CValadez94/F20_Schematics/PDM_Layout.pdf

Specs

Page 1

R1 | R4 | F2 ECU BAT 10A | F8 FPUMP RLY 20A | F14 SHIFTERS 5A
MAIN | INJ | F3 ECU IGN 3A | F9 INJ RLY 30A | F15 ECU +5V_1 3A
R2 | R5 | F4 MAIN RLY 30A | F10 COILS RLY 30A | F16 ECU +5V_2 3A
FAN | COILS | F5 ECU 12V RLY 20A | F11 AUX RLY 10A
R3 FUEL | R6 | F6 O2 SENSOR 5A | F12 RIM 2A
| AUX | F7 FAN RLY 30A | F13 TRANSP 1A
