CValadez94/F20_Schematics/ConnPinout.xlsx

Sheet: Connectors
IC = inter connect
CC = component connector
PT = pigtail
RT = ring terminal
R = receptacle
P = plug
SH = shield
Ref | Start | End | Ckt ID | Color | AWG
ICP1 | 1 | S1:1 | 1BP | RED
 | 2 | CCP1:2 | 1CT1
 | 3 | CCP2:2 | 1CT2
 | 4 | CCP3:2 | 1CT3
 | 5 | CCP4:2 | 1CT4
 | 6 | S2:1 | 2BP | RED
 | 7 | CCR1:1 | 3CT1
 | 8 | CCR1:2 | 3CT2
 | 9 | CCR1:3 | 3CT3
 | 10 | CCR1:4 | 3CT4
 | 11 | CCR2:3 | 3BG | BLACK
 | 12 | RT1 | 4BP | RED
 | 13 | ICR7:1 | 5BP | RED
 | 14 | S3:1 | 6AP2 | RED
 | 15 | S4:1 | 7AG1 | GRAY
 | 16 | ICR5:1 | 8SI
 | 17 | ICR6:1 | 9SI
 | 18 | ICR2:1 | 10SI
 | 19 | ICR3:1 | 11SI
 | 20 | ICR4:1 | 12SI
 | 21 | ICP6:1 | 22SI
ICR1 | 1 |  | 13SI
 | 2 |  | 14SI
 | SH |  | 13SH
ICP2 | 1 |  | 15SI
 | 2 |  | 16SI
 | SH |  | 15SH
ICR8 | 1 | S5 | 21BP
 | 2 |  | 18CT
 | 3 |  | 19CT
ICR9 | 1 | S5 | 21BP
 | 2 |  | 20CT
CCR2 | 1 | CCP5:2 | 2CT1
 | 2 | CCP6:2 | 2CT2
 | 3 | ICP1:11 | 3BG | BLACK
 | 4 | CCP7:2 | 2CT3
 | 5 | CCP8:2 | 2CT4
S1 | 1 | ICP1:1 | 1BP | RED
 | 2 | CCP1:1 | 1BP
 | 3 | CCP2:1 | 1BP
 | 4 | CCP3:1 | 1BP
 | 5 | CCP4:1 | 1BP
S2 | 1 | ICP1:6 | 2BP
 | 2 | CCP5:1 | 2BP
 | 3 | CCP6:1 | 2BP
 | 4 | CCP7:1 | 2BP
 | 5 | CCP8:1 | 2BP
S3 | 1 | ICP1:14 | 6AP2 | RED
 | 2 | ICR2:2 | 6AP2
 | 3 | ICR3:3 | 6AP2
 | 4 | ICR4:2 | 6AP2
 | 5 | ICR5:3 | 6AP2
 | 6 | ICR6:3 | 6AP2
S4 | 1 | ICP1:15 | 7AG1 | GRAY
 | 2 | ICR3:2 | 7AG1
 | 3 | ICR5:2 | 7AG1
 | 4 | ICR6:2 | 7AG1
S5 | 1 |  | 21BP
 | 2 | ICR9:1 | 21BP
 | 3 | ICR8:1 | 21BP

Sheet: Circut ID Naming
Ex | 1BP = Injectors Battery Power (12V)
Ckt Number |  | Type |  | Misc Flag (Optional)
1 | Injectors | BP | Battery Power (12V) | Chronological numbering scheme to differentiate multiples. For example, (1CT1, 1CT2, 1CT3, 1CT4) refers to control wires of injectors 1, 2, 3 and 4 respectively.
2 | Coils | AP | Aux Power (5V)
3 | Coil Driver | BG | Battery Ground
4 | Fuel Pump | CG | Chassis Ground
5 | Fan | AG | Analog Ground
6 | ECU_+5V | CT | Control
7 | ECU_AGND | DD | Digital Data
8 | TPS | SI | Signal
9 | MAP | SH | Wire shielding
10 | ECT
11 | EOP
12 | IAT
13 | Crank_VR+
14 | Crank_VR-
15 | Cam_VR+
16 | Cam_VR-
17 | O2 Sensor
18 | Up Shift
19 | Down Shift
20 | Clutch
21 | Shift Solenoids
22 | Brake Light
23
24
25
26
27
28
29
30
