CValadez94/F20_Schematics/PDM_Layout.xlsx

Sheet: Specs
R1 MAIN | R4 INJ | F2 ECU BAT 10A | F2 ECU BAT 10A | F8 FPUMP RLY 20A | F14 SHIFTERS 5A
 |  | F3 ECU IGN 3A |  | F9 INJ RLY 30A | F15 ECU +5V_1 3A
R2 FAN | R5 COILS | F4 MAIN RLY 30A | F4 MAIN RLY 30A | F10 COILS RLY 30A | F16 ECU +5V_2 3A
 |  | F5 ECU 12V RLY 20A |  | F11 AUX RLY 10A
R3 FUEL | R6 AUX | F6 O2 SENSOR 5A |  | F12 RIM 2A
 |  | F7 FAN RLY 30A |  | F13 TRANSP 1A

Sheet: Sheet1
6 ultra micro relays (4pin – 20A) 24 fuses
6 micro relays (4/5 pin – 35A) 18 fuses
5 micro relays (4/5 pin – 35A) 20 fuses
