CValadez94/F20_Schematics/WiringDiagrams.pdf

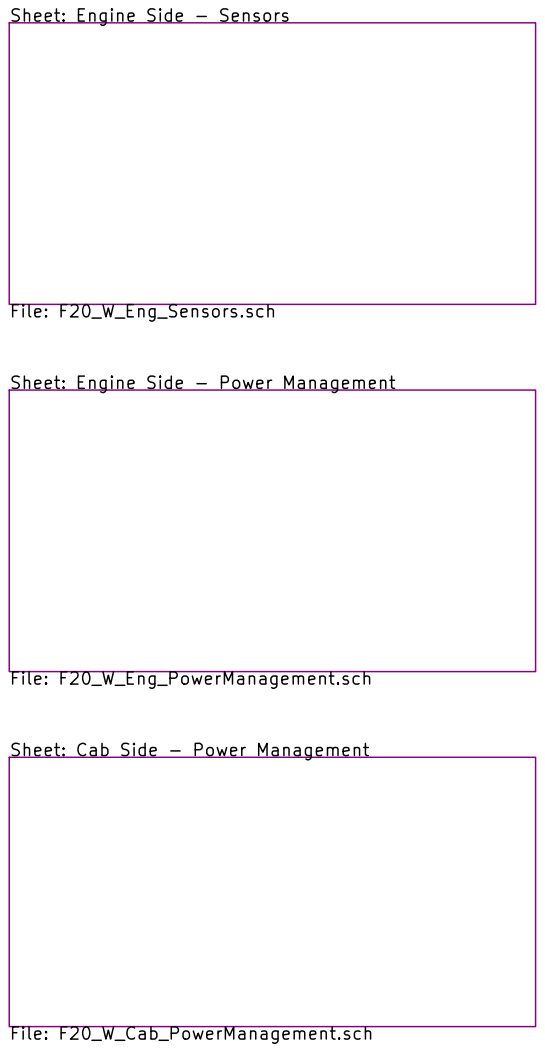
[picture p1: page 1]

Sheet: Engine Side - Sensors

Sheet: Engine Side - Power Management

Sheet: Cab Side - Power Management

Id: 1/4 Title: Root - Wiring

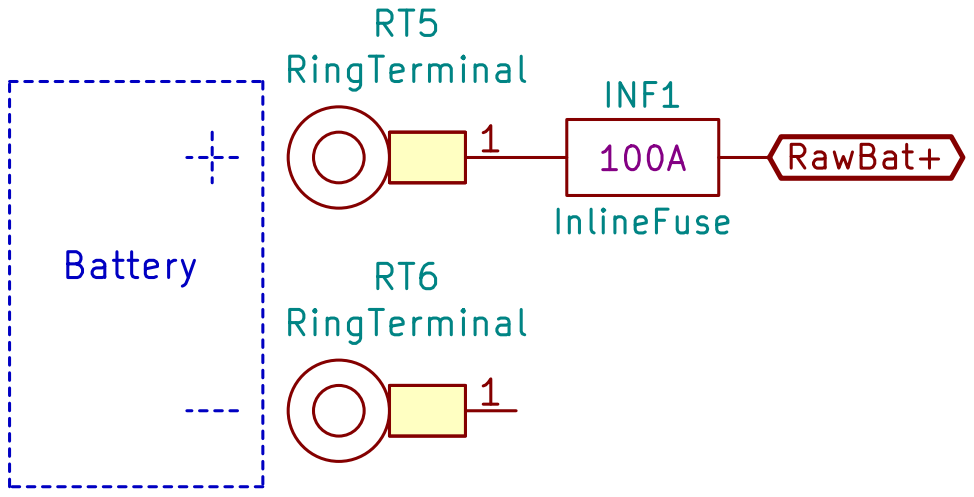
[picture p2: page 2]

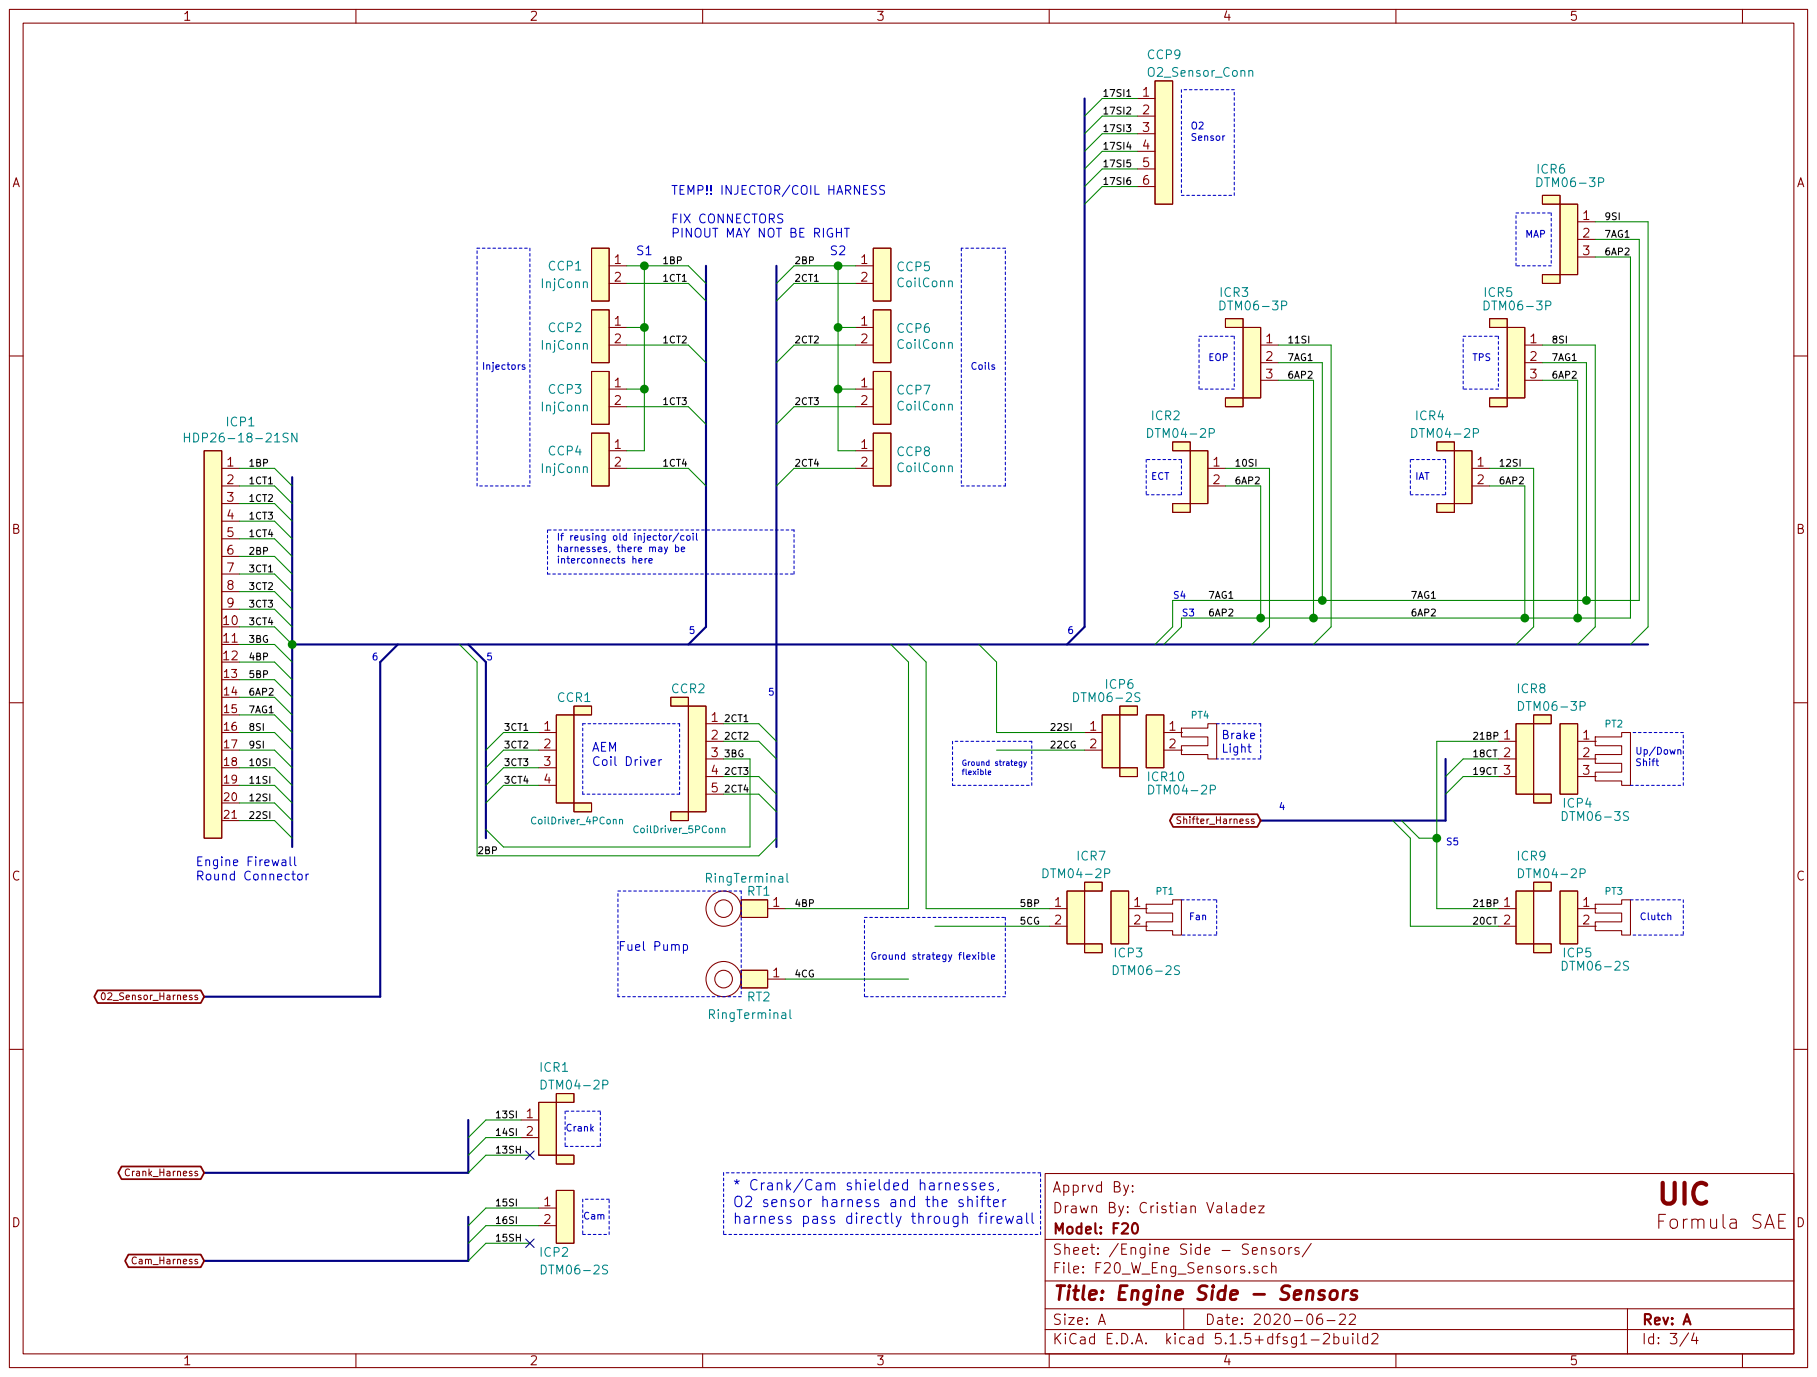
[picture p3: page 3]

1CT1 TEMP!! INJECTOR/COIL HARNESS

FIX CONNECTORS
PINOUT MAY NOT BE RIGHT

If reusing old injector/coil harnesses, there may be

Fan Crank Engine Firewall Round Connector

* Crank/Cam shielded harnesses, O2 sensor harness and the shifter harness pass directly through firewall

File: F20_W_Eng_Sensors.sch
Id: 3/4 Title: Engine Side - Sensors

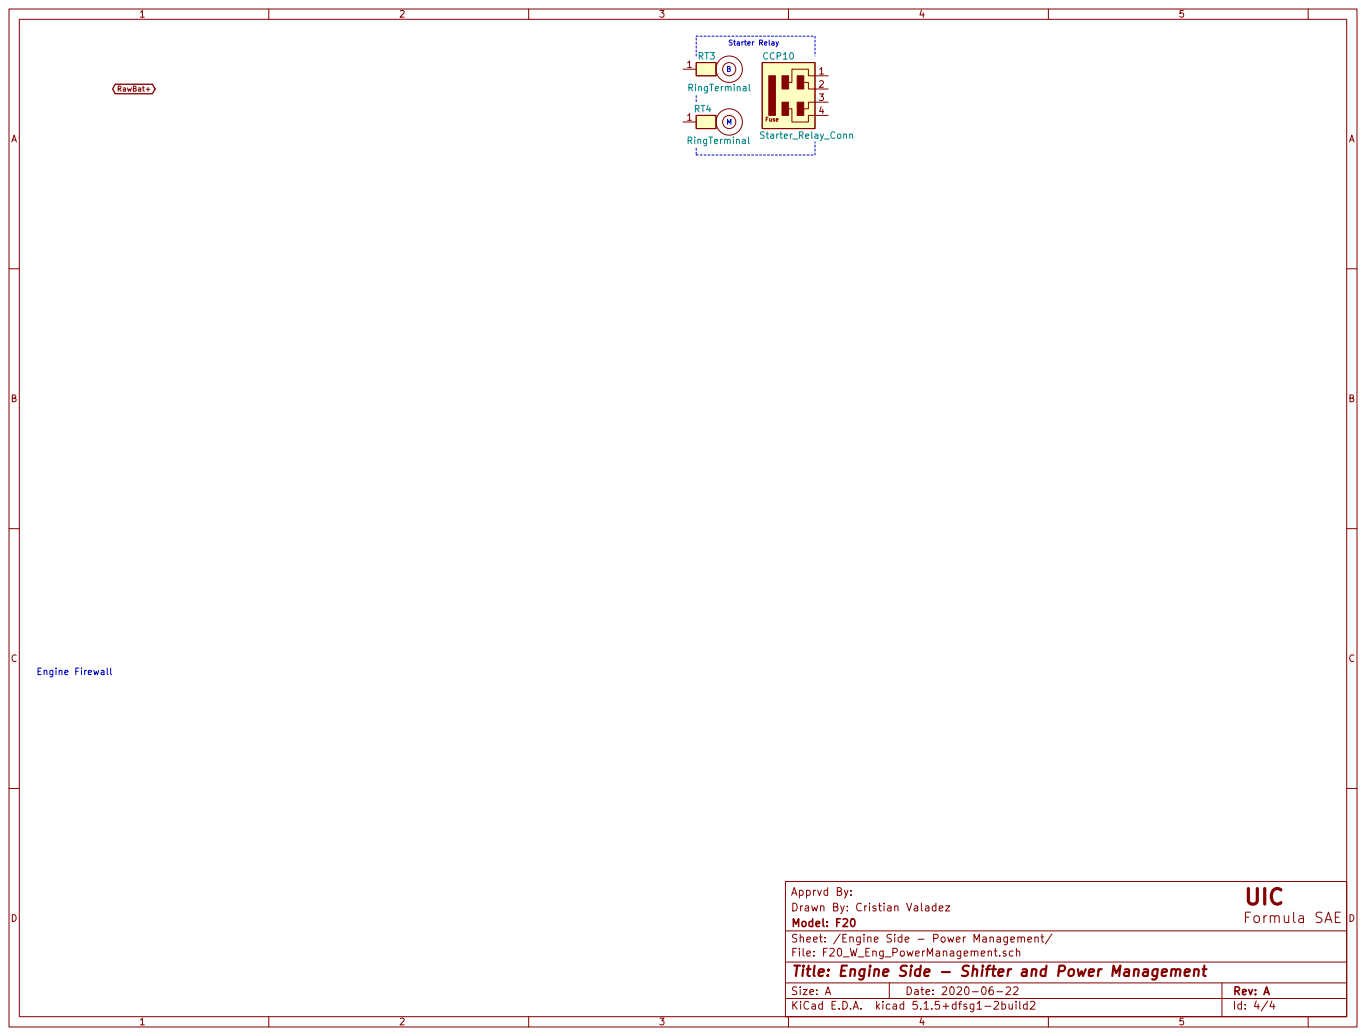
[picture p4: page 4]

File: F20_W_Eng_PowerManagement.sch
Id: 4/4 Title: Engine Side - Shifter and Power Management
