CValadez94/F20_Schematics/LogicDiagrams.pdf

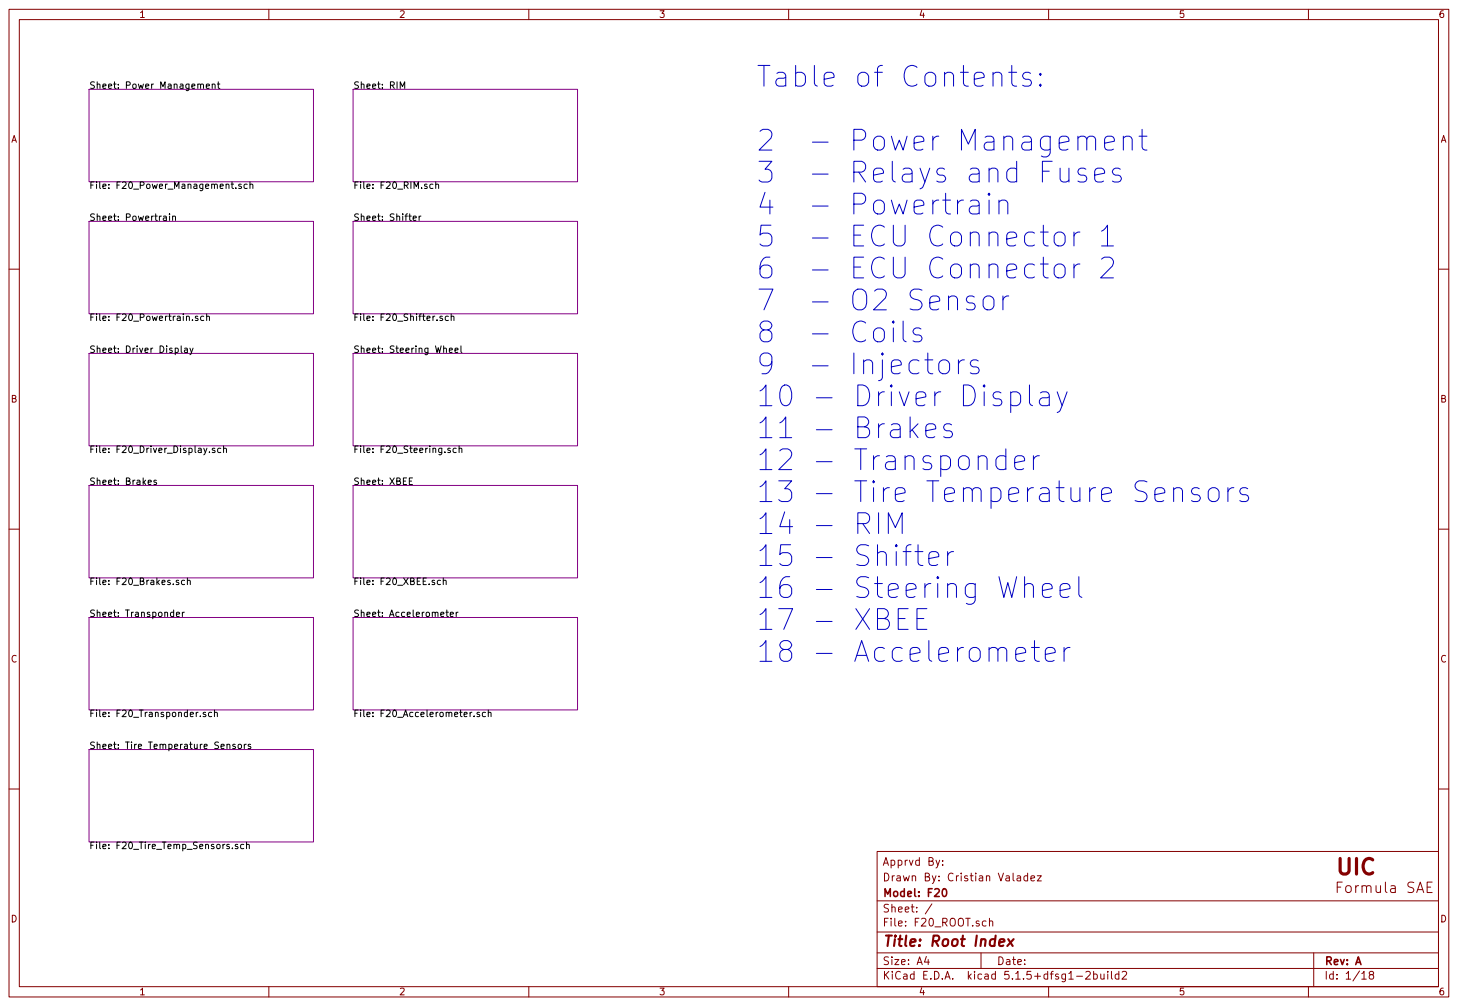
[picture p5: page 1]

File: F20_Power_Management.sch Sheet: Powertrain File: F20_Powertrain.sch Sheet: Driver Display

File: F20_RIM.sch Sheet: Shifter File: F20_Shifter.sch Sheet: Steering Wheel

File: F20_Driver_Display.sch Sheet: Brakes File: F20_Brakes.sch Sheet: Transponder

File: F20_Steering.sch Sheet: XBEE

Sheet: Tire Temperature Sensors

Id: 1/18 Title: Root Index

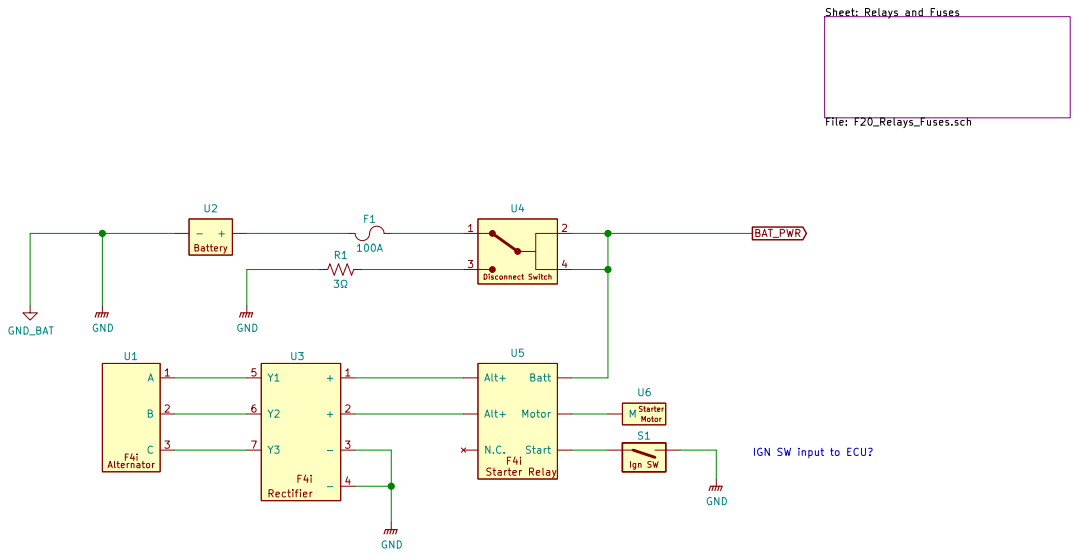
[picture p6: page 2]

Sheet: Relays and Fuses

IGN SW input to ECU?

File: F20_Power_Management.sch
Id: 2/18 Title: Fuses and Relays

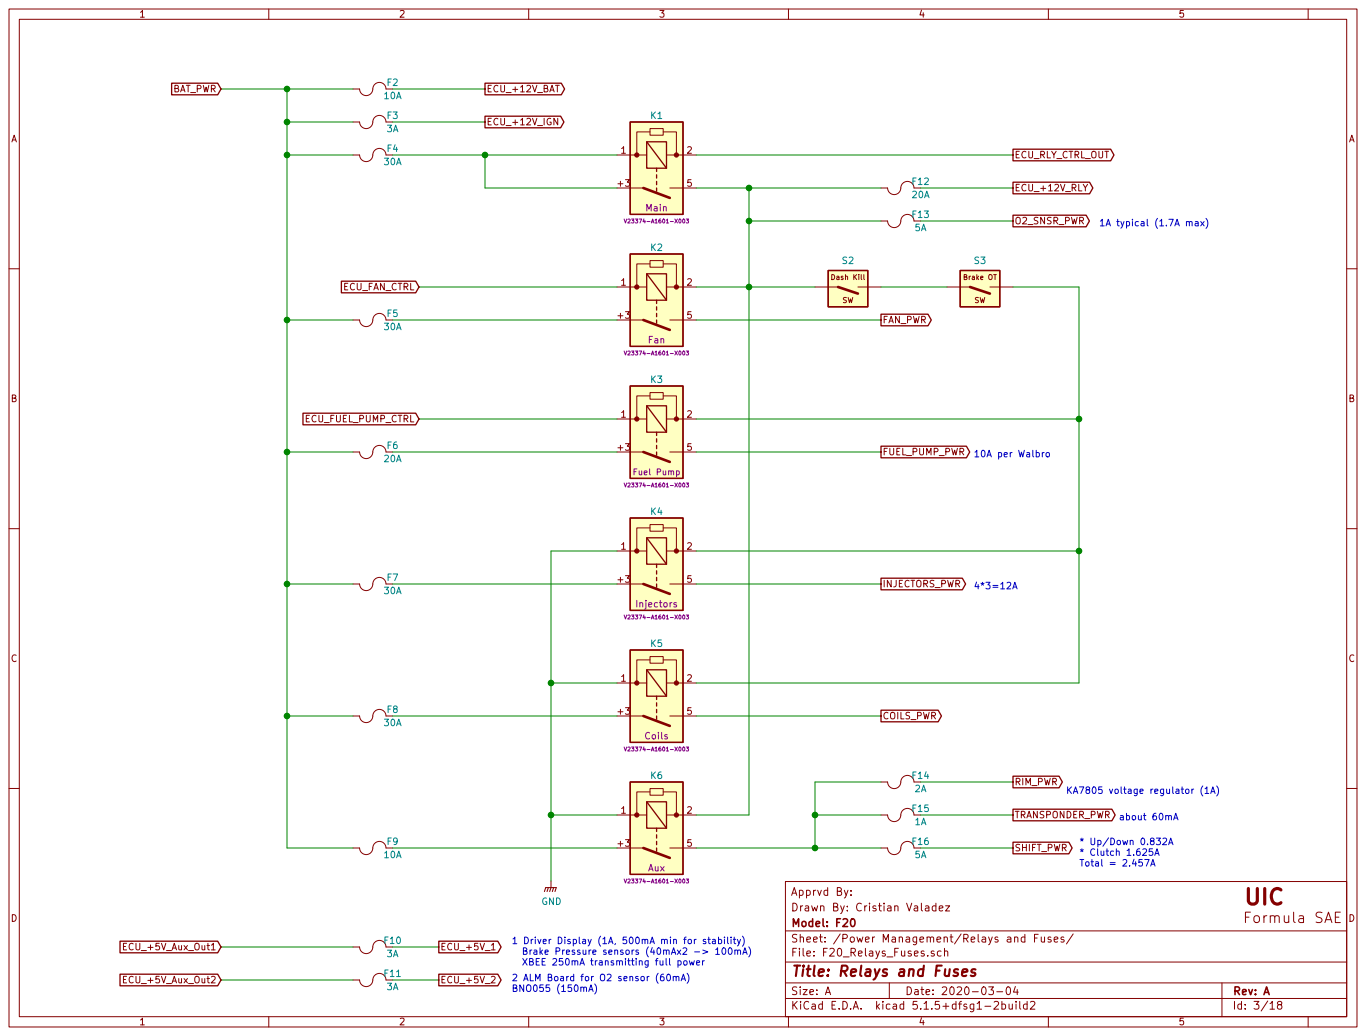
[picture p7: page 3]

1 Driver Display (1A, 500mA min for stability)
Brake Pressure sensors (40mAx2 -> 100mA)
XBEE 250mA transmitting full power
2 ALM Board for O2 sensor (60mA)

File: F20_Relays_Fuses.sch
Id: 3/18 Title: Relays and Fuses

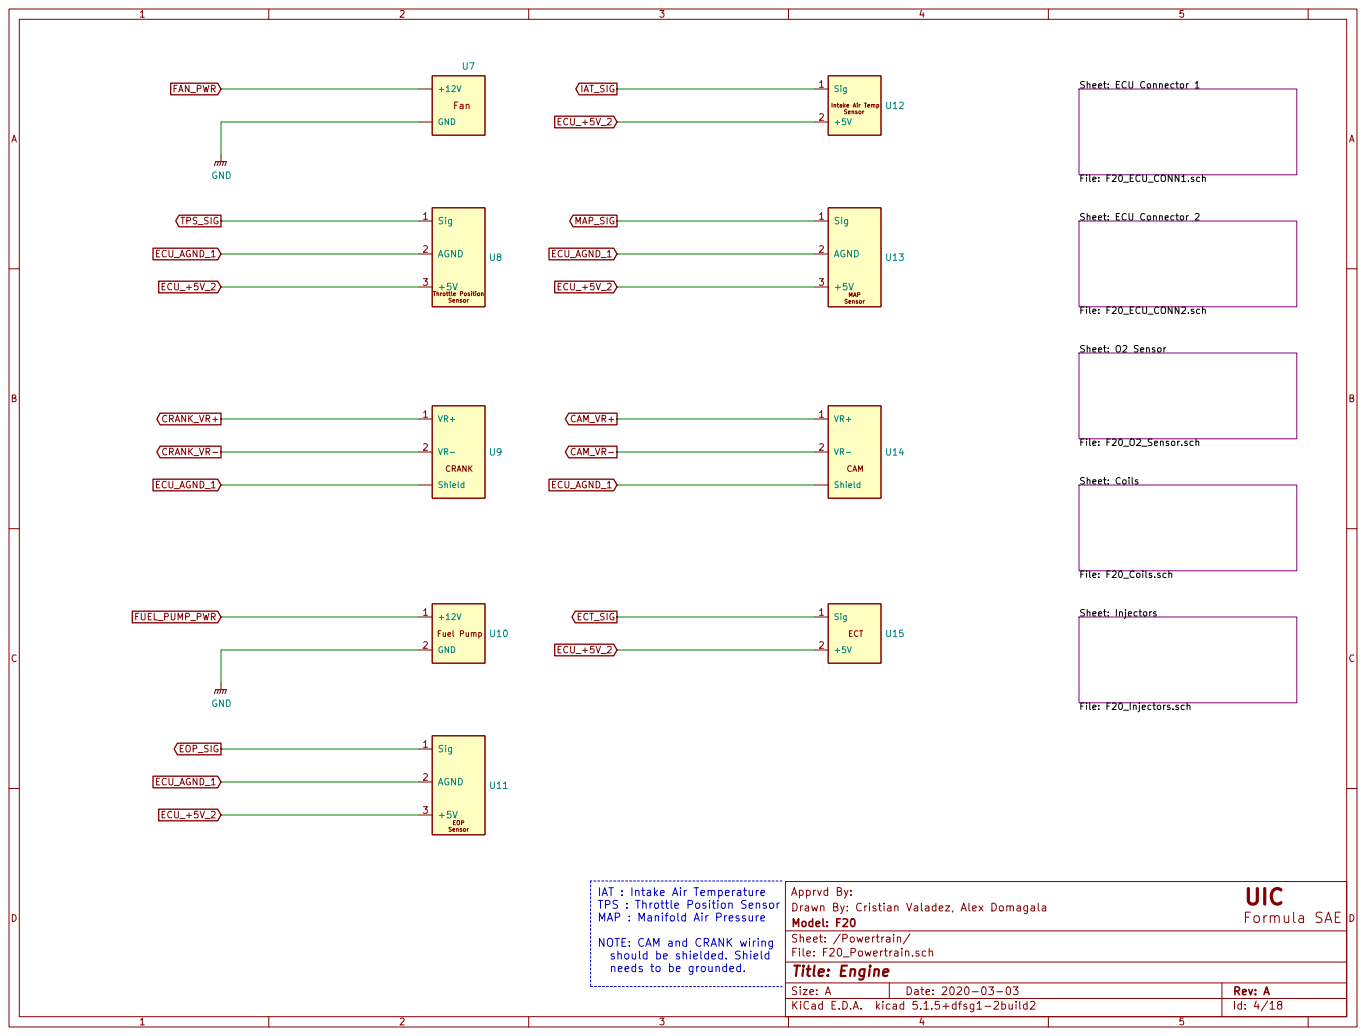
[picture p8: page 4]

Sheet: ECU Connector 1 File: F20_ECU_CONN1.sch GND

Intake Air Temp Sensor Sig 1
Sheet: ECU Connector 2 File: F20_ECU_CONN2.sch Sheet: O2 Sensor File: F20_O2_Sensor.sch Sheet: Coils File: F20_Coils.sch Sheet: Injectors

IAT : Intake Air Temperature
TPS : Throttle Position Sensor MAP : Manifold Air Pressure NOTE: CAM and CRANK wiring

should be shielded. Shield
needs to be grounded.

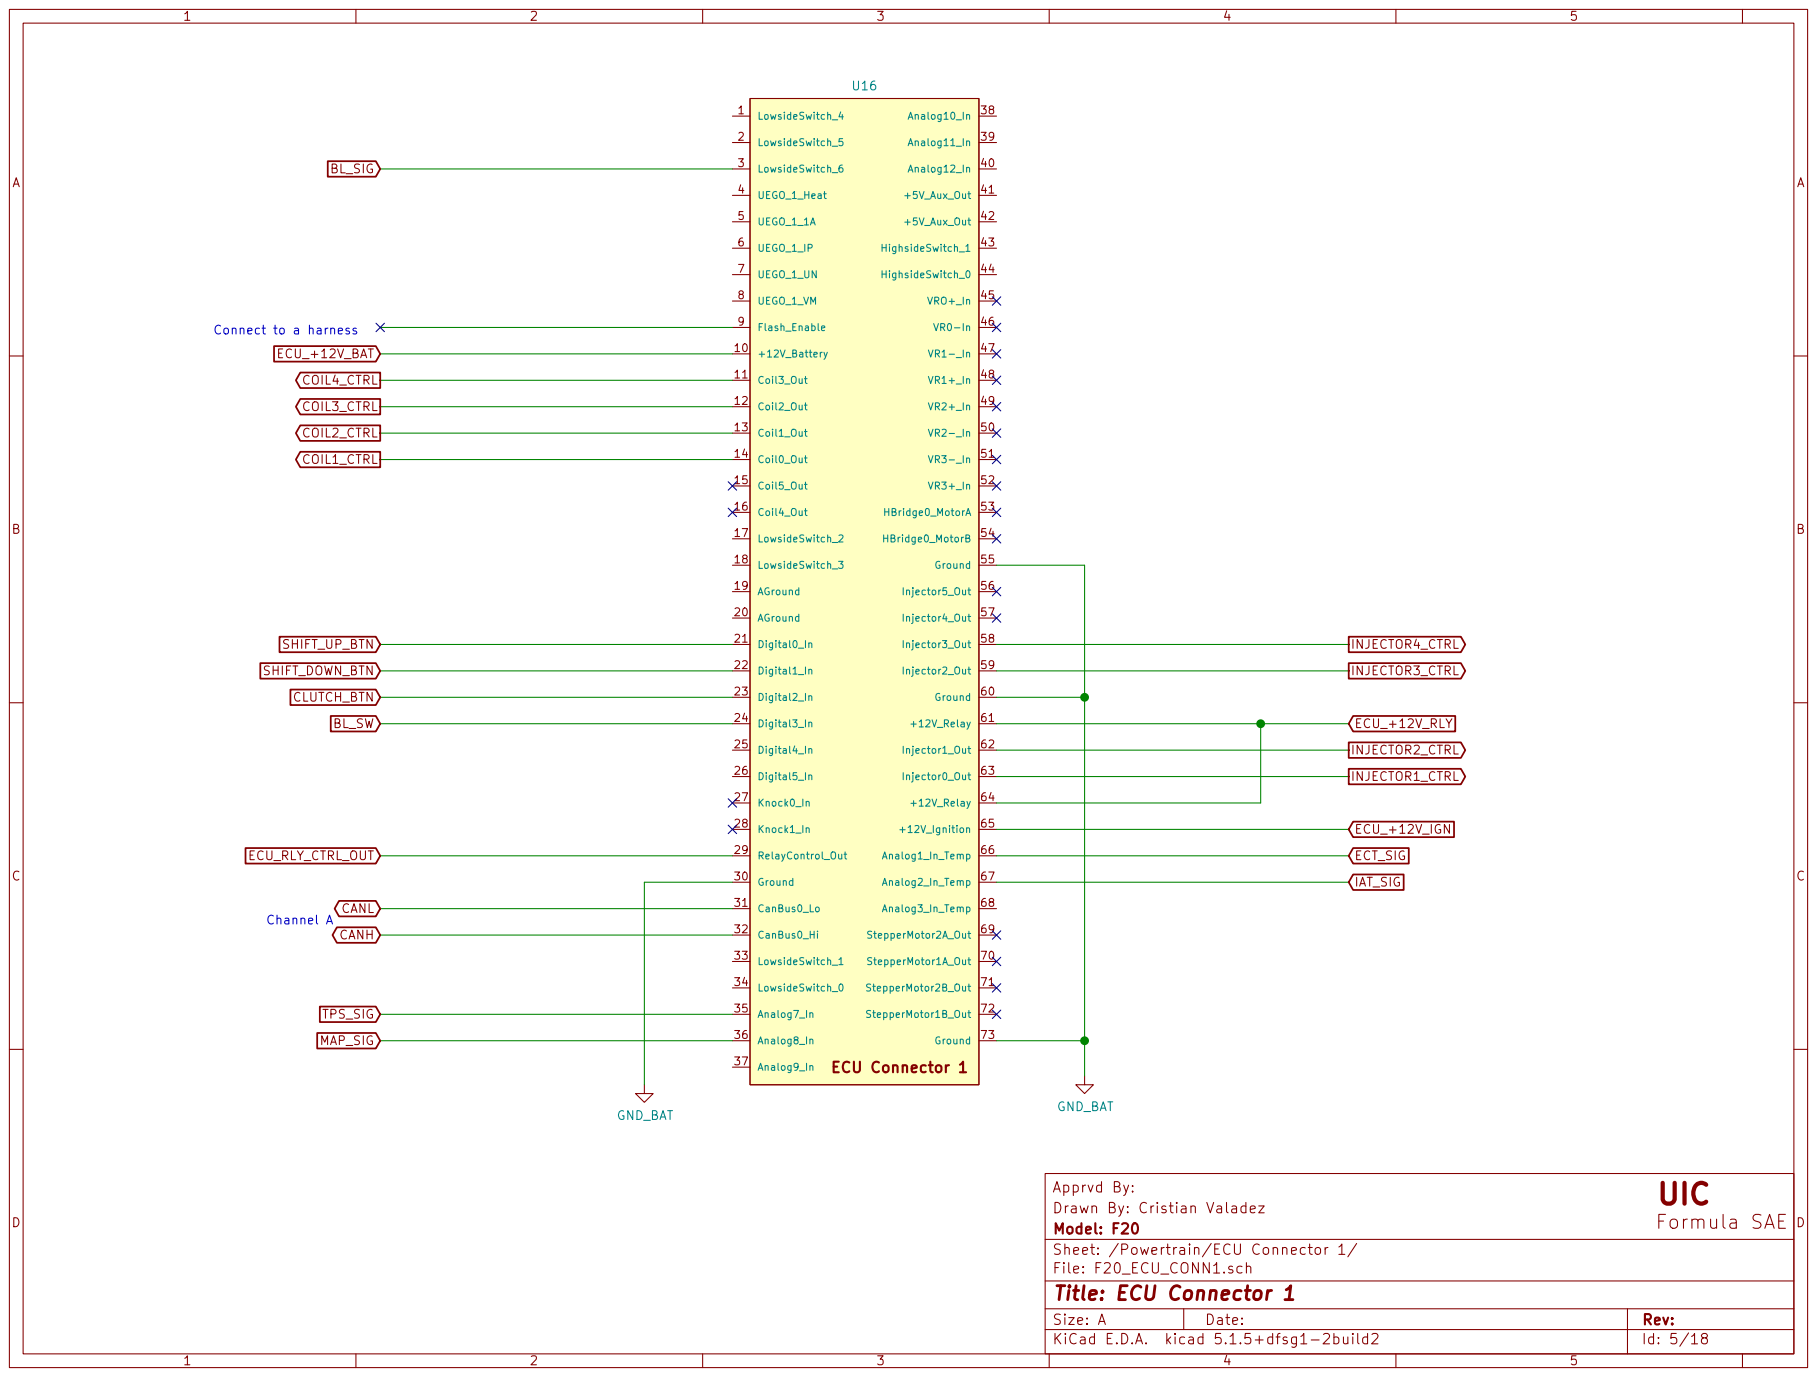
[picture p9: page 5]

Id: 5/18 Title: ECU Connector 1

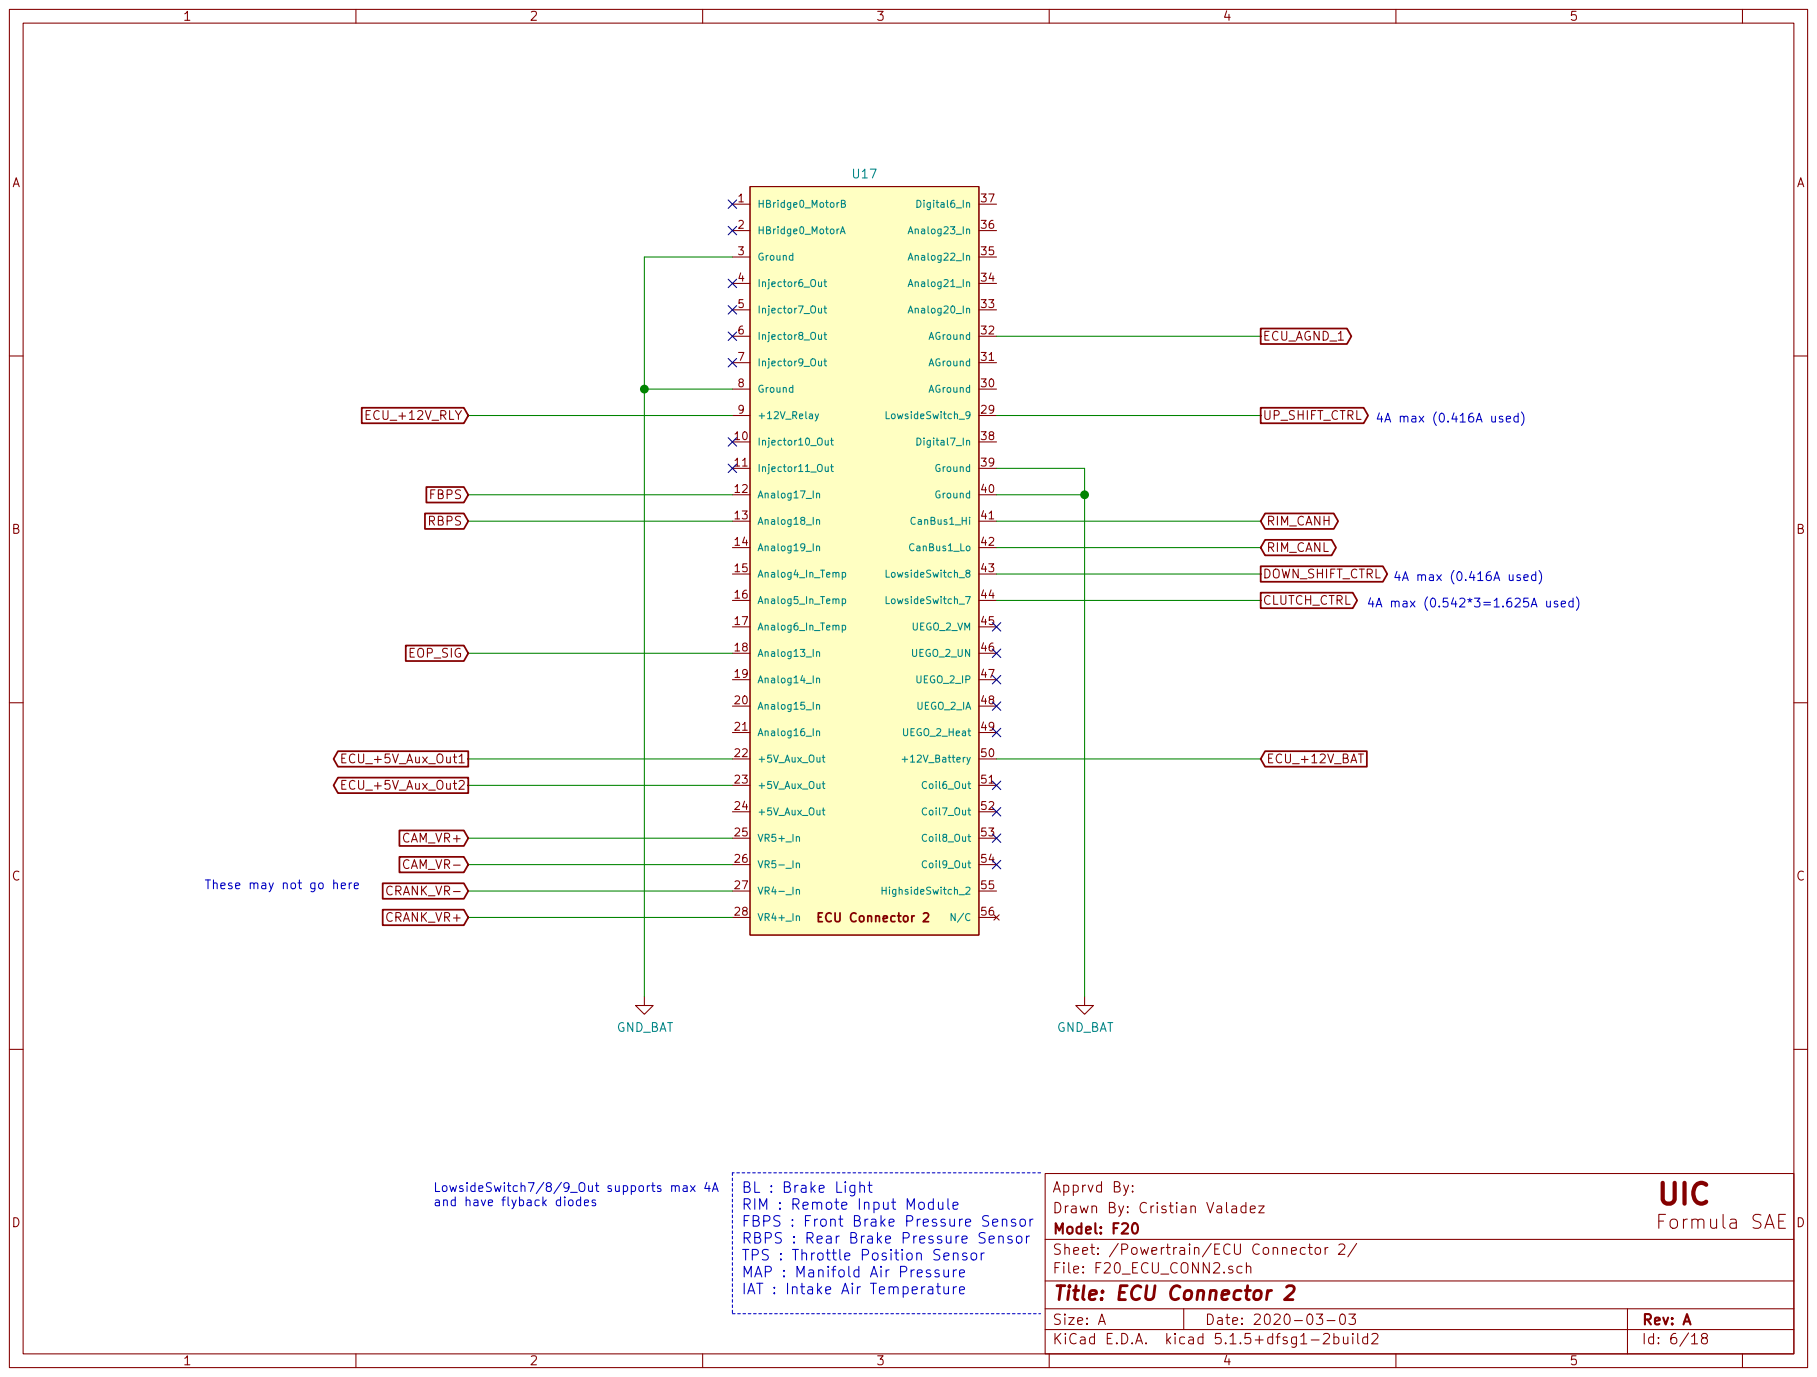
[picture p10: page 6]

These may not go here

LowsideSwitch7/8/9_Out supports max 4A
and have flyback diodes

RIM : Remote Input Module
FBPS : Front Brake Pressure Sensor
RBPS : Rear Brake Pressure Sensor
TPS : Throttle Position Sensor MAP : Manifold Air Pressure

IAT : Intake Air Temperature

Id: 6/18 Title: ECU Connector 2

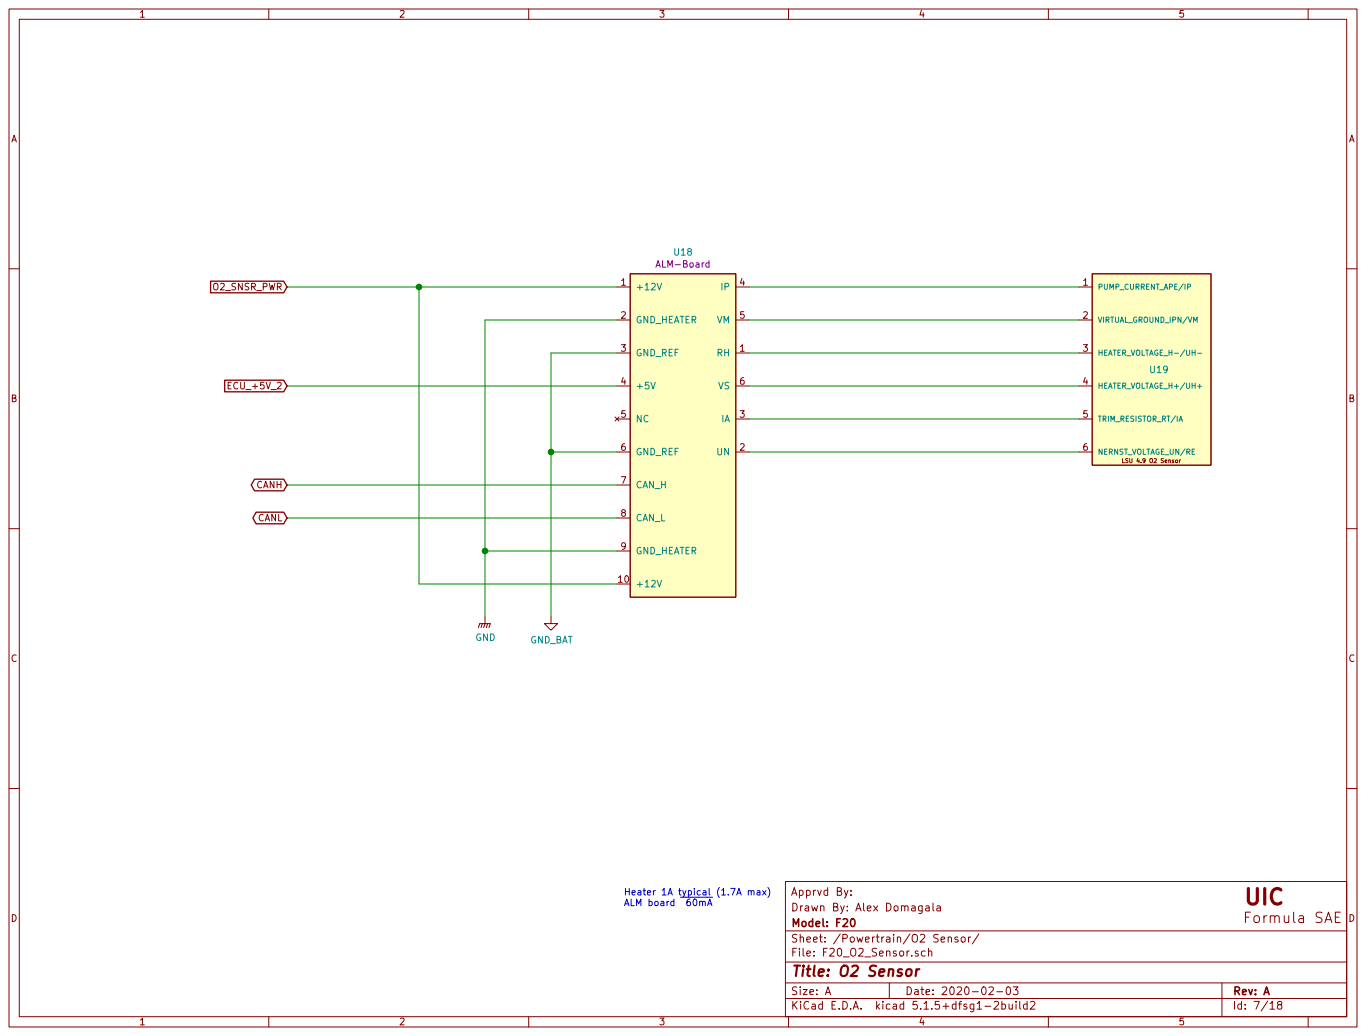
[picture p11: page 7]

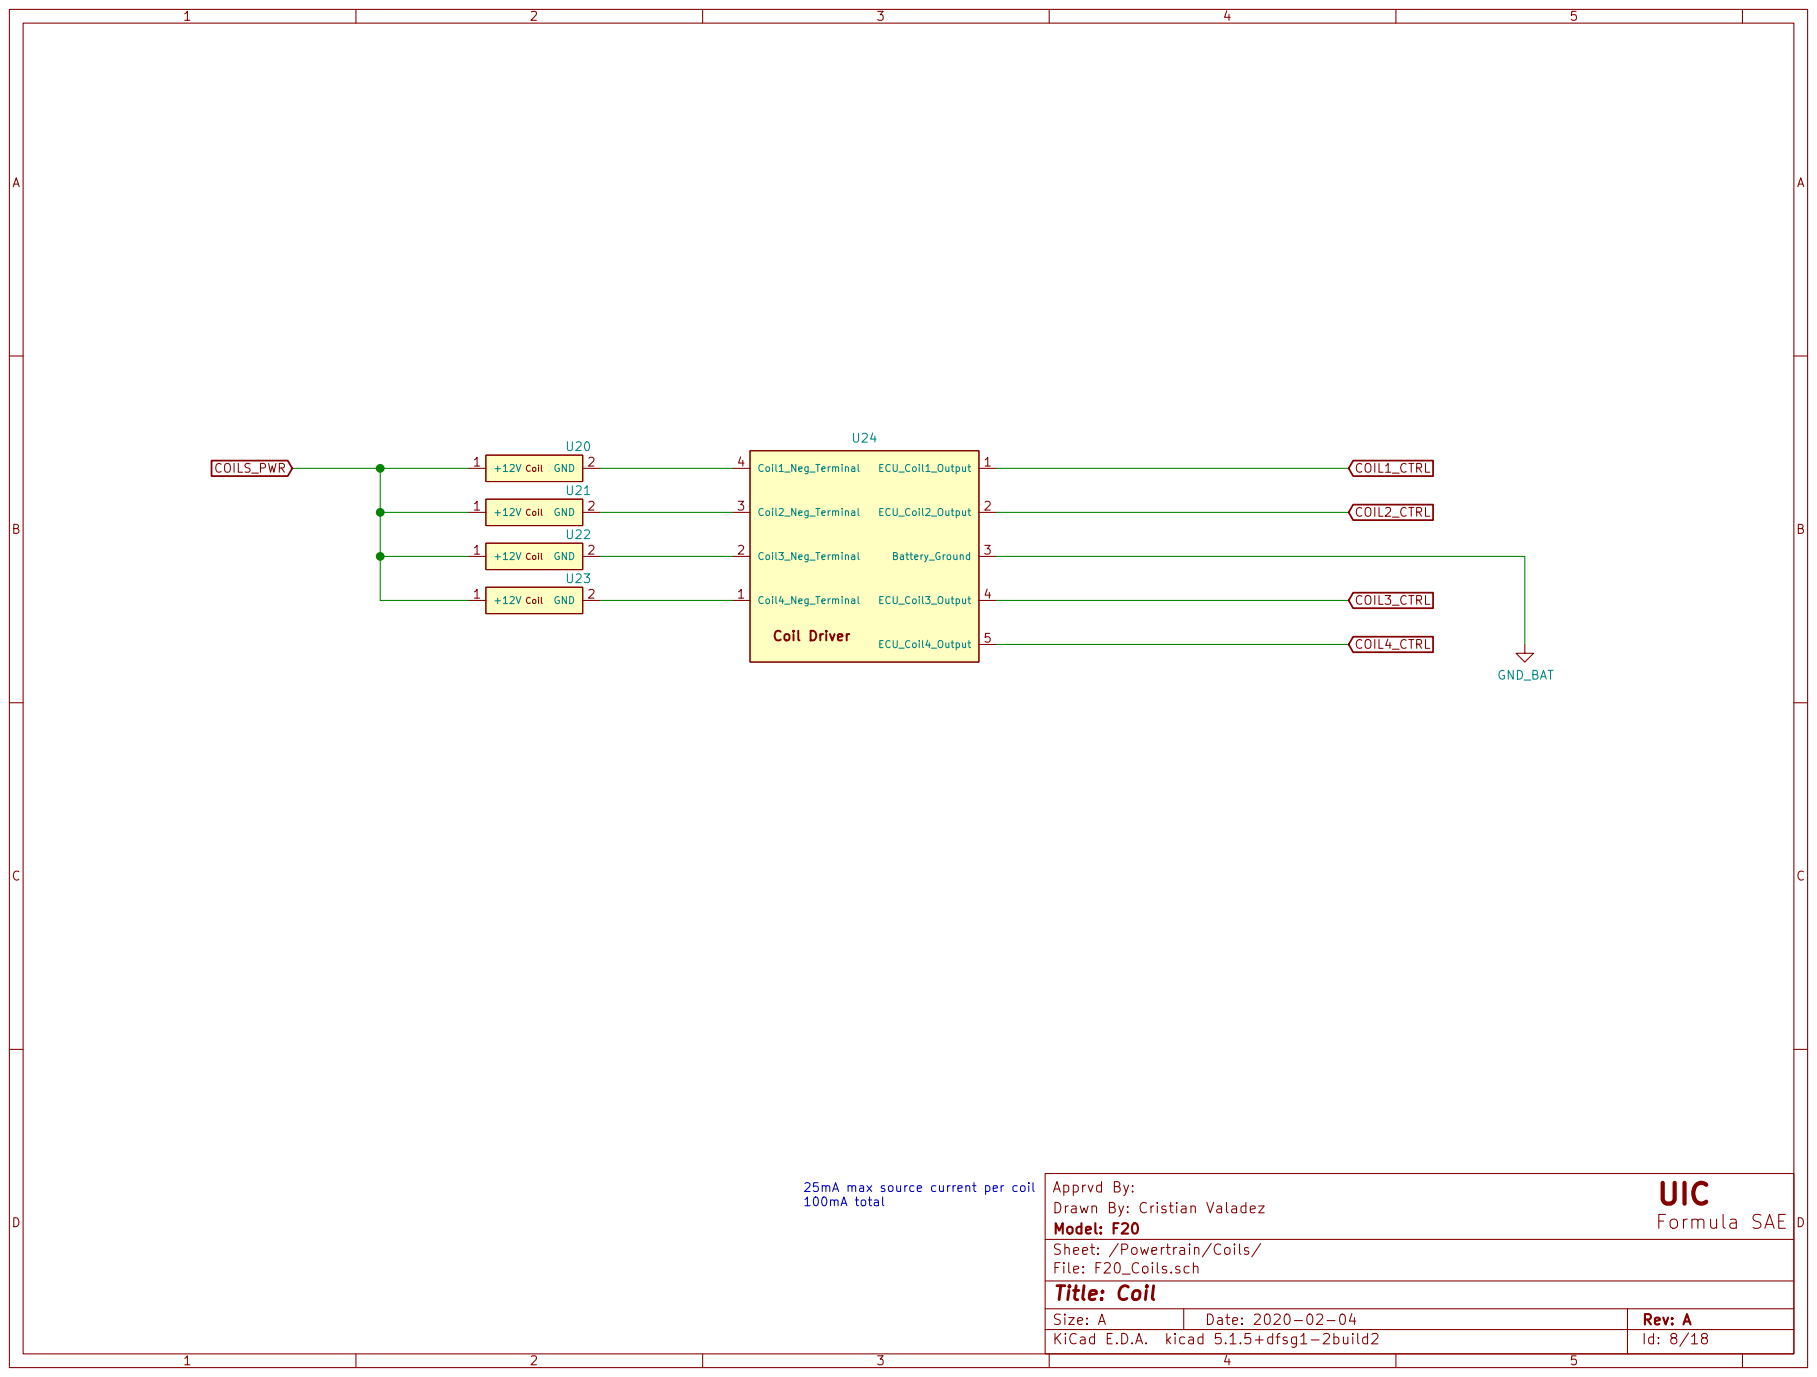
[picture p12: page 8]

25mA max source current per coil 100mA total

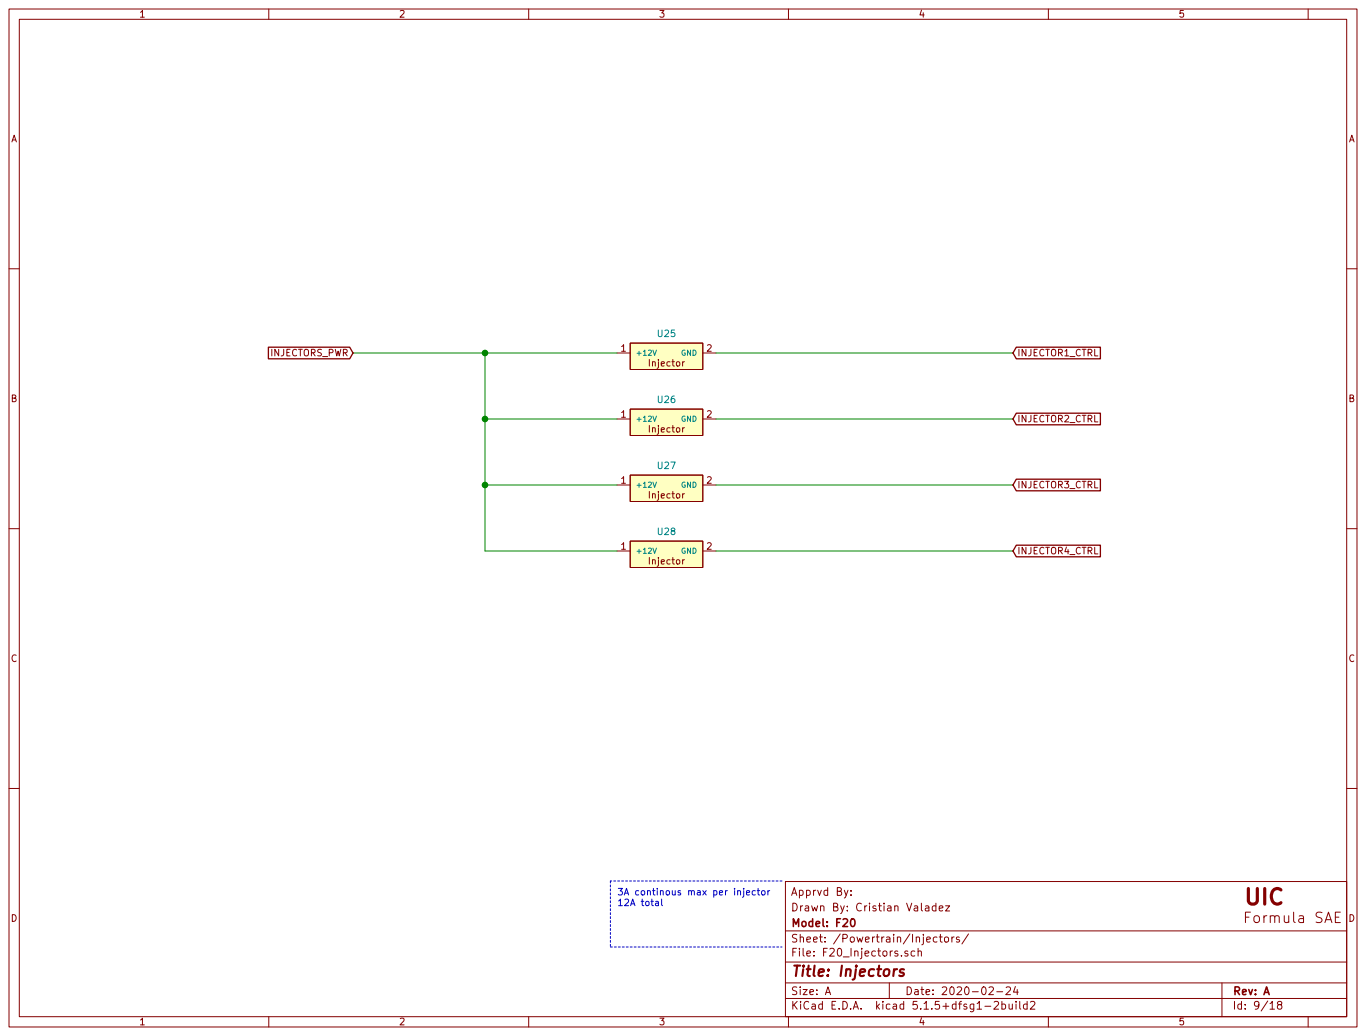
[picture p13: page 9]

3A continous max per injector 12A total

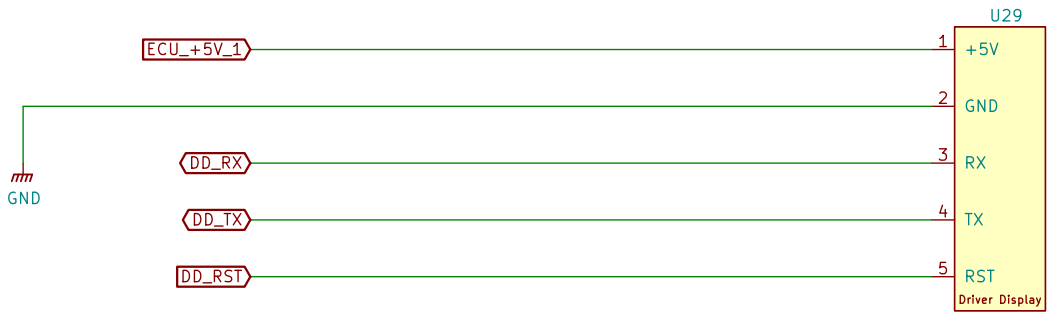
[picture p14: page 10]

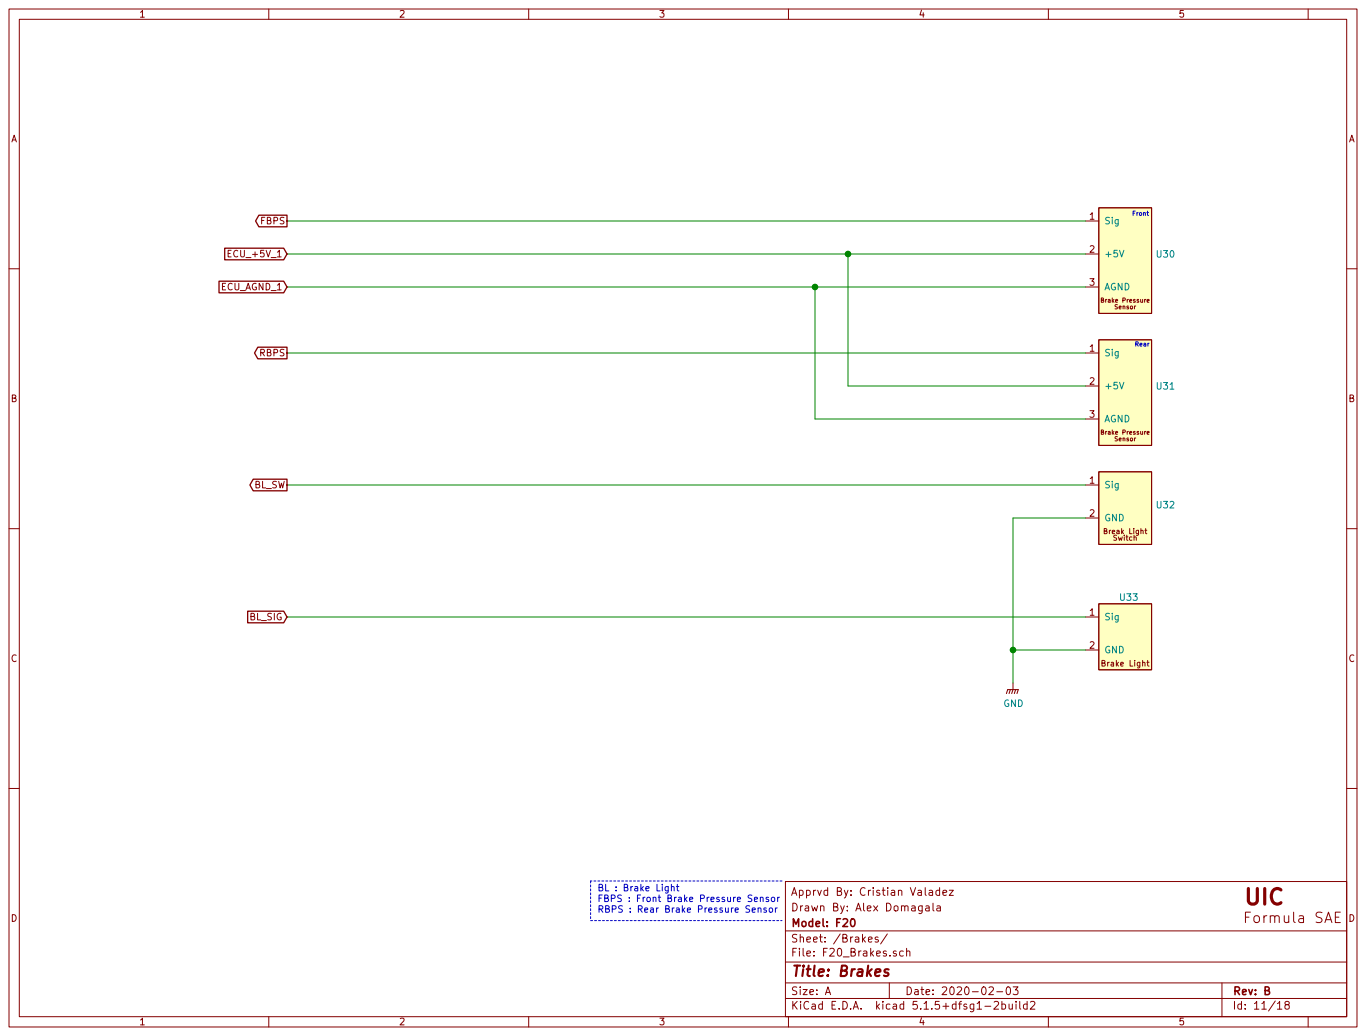
[picture p15: page 11]

Front Rear BL : Brake Light FBPS : Front Brake Pressure Sensor RBPS : Rear Brake Pressure Sensor

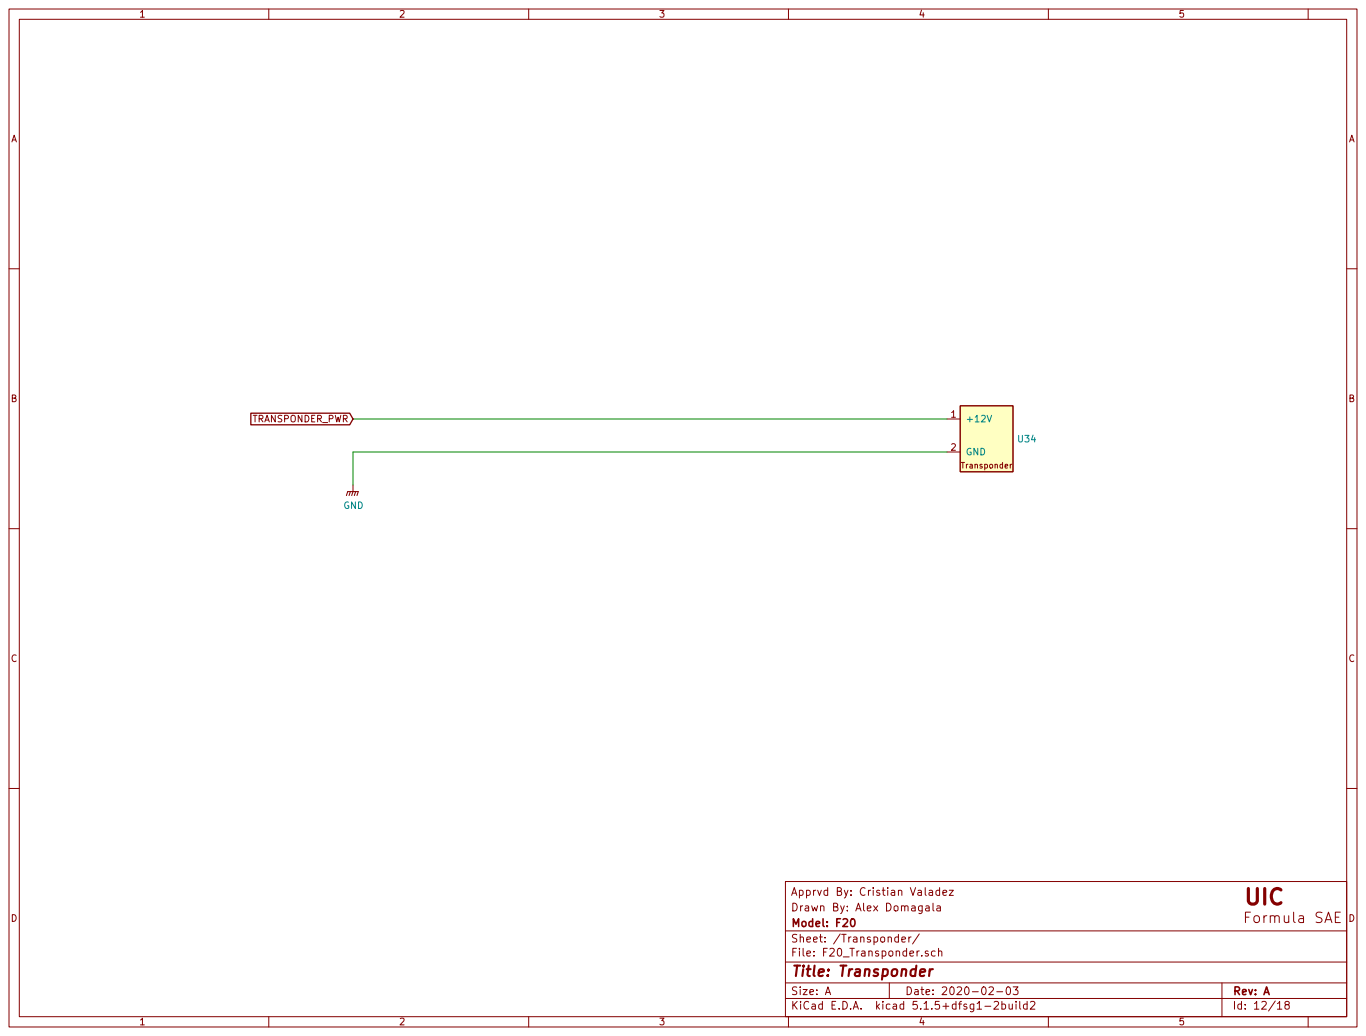
[picture p16: page 12]

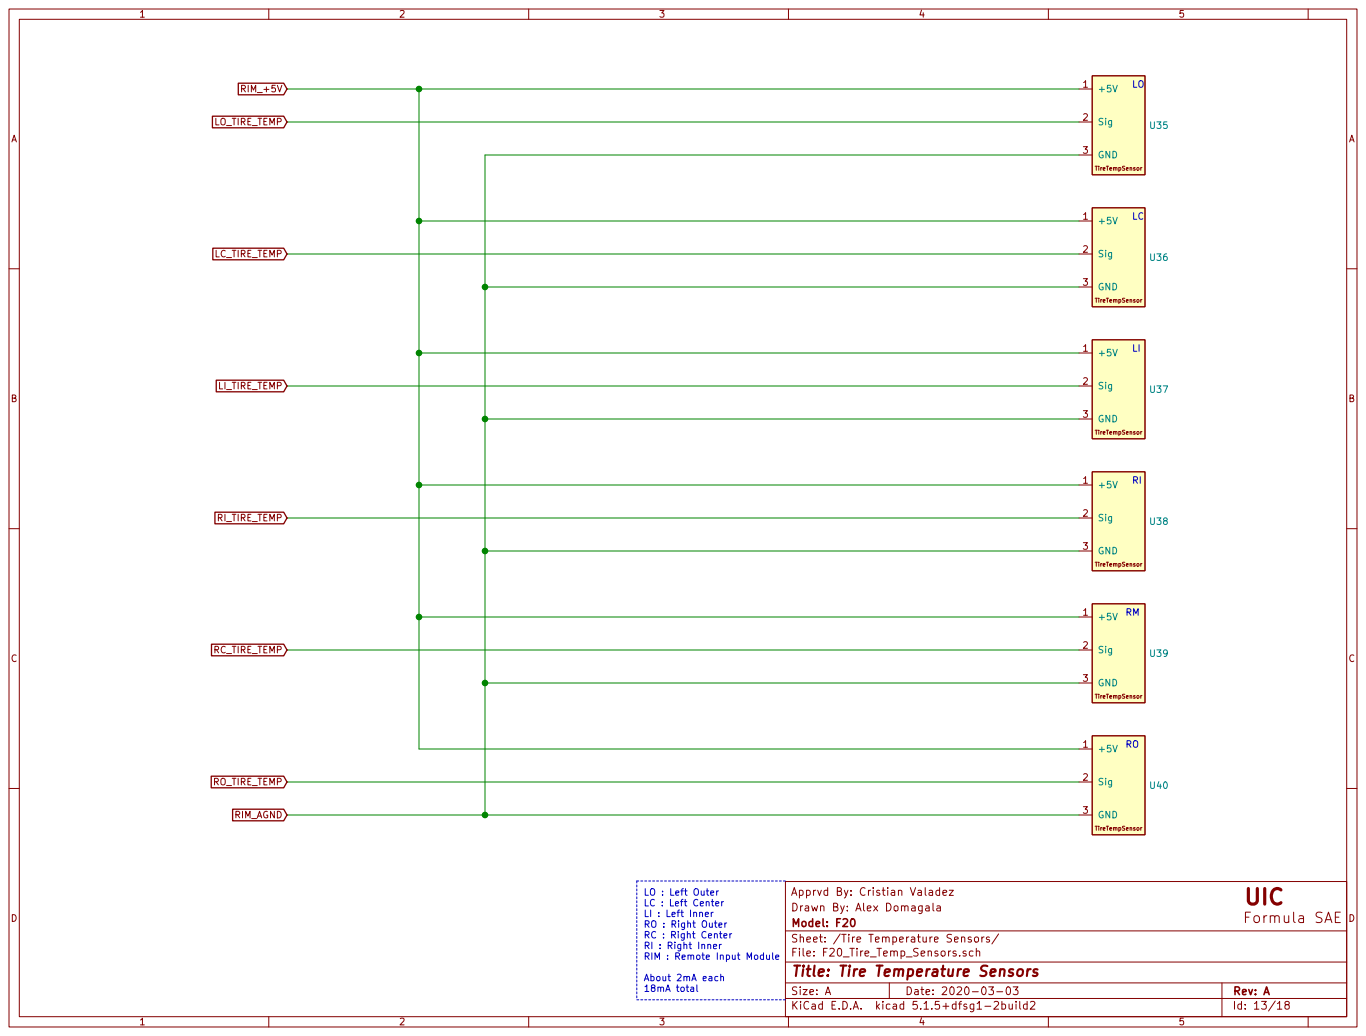
[picture p17: page 13]

LO : Left Outer LC : Left Center LI : Left Inner RO : Right Outer

RC : Right Center
RI : Right Inner
RIM : Remote Input Module About 2mA each

File: F20_Tire_Temp_Sensors.sch
Id: 13/18 Title: Tire Temperature Sensors

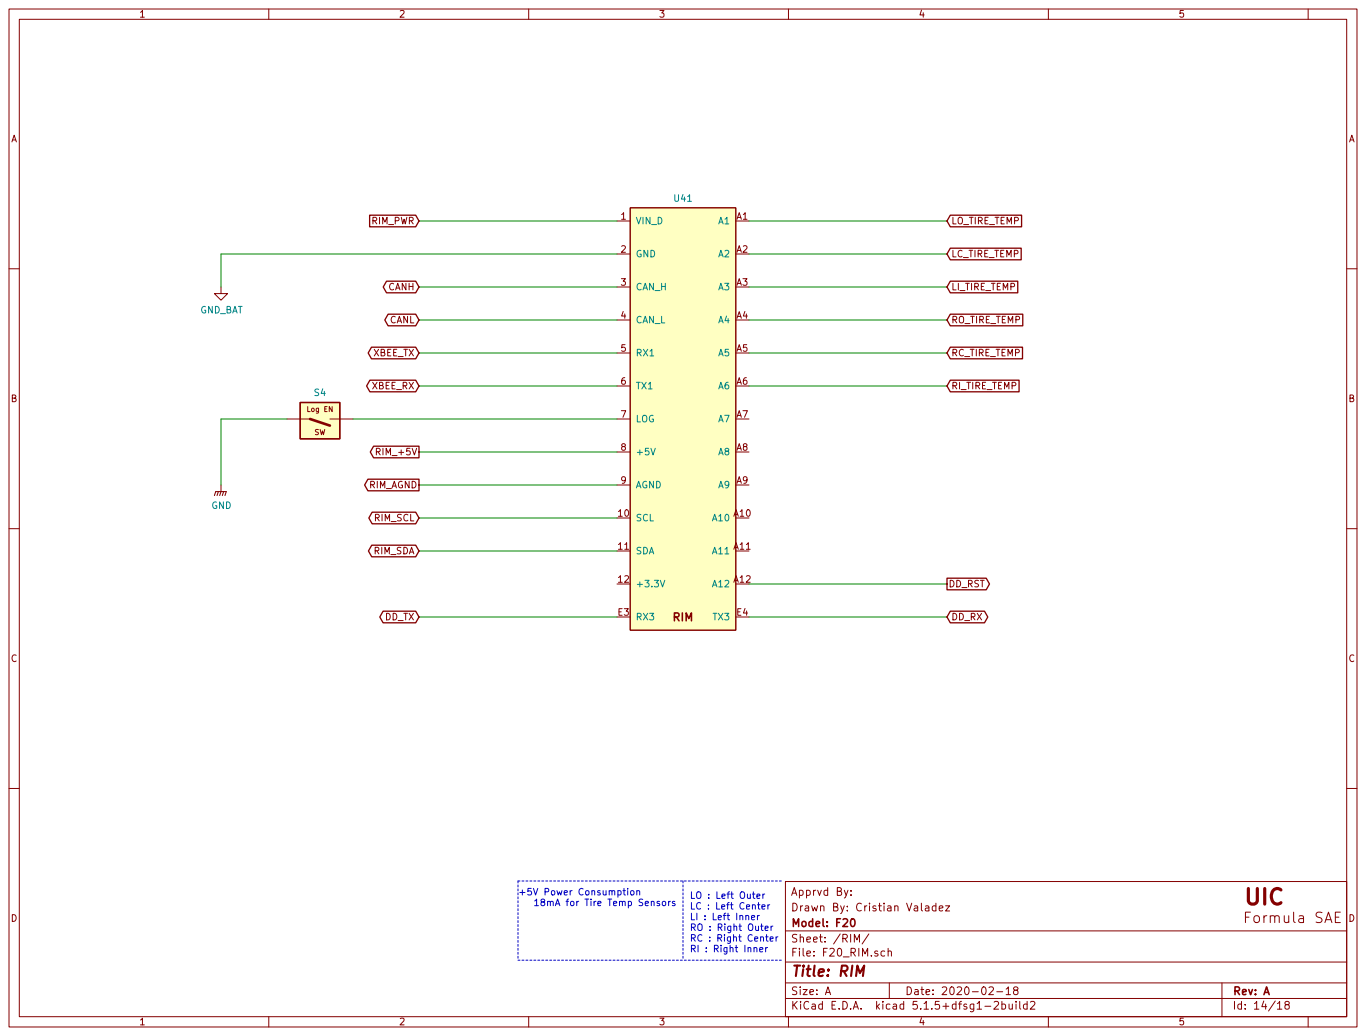
[picture p18: page 14]

+5V Power Consumption
18mA for Tire Temp Sensors

LO : Left Outer LC : Left Center LI : Left Inner RO : Right Outer

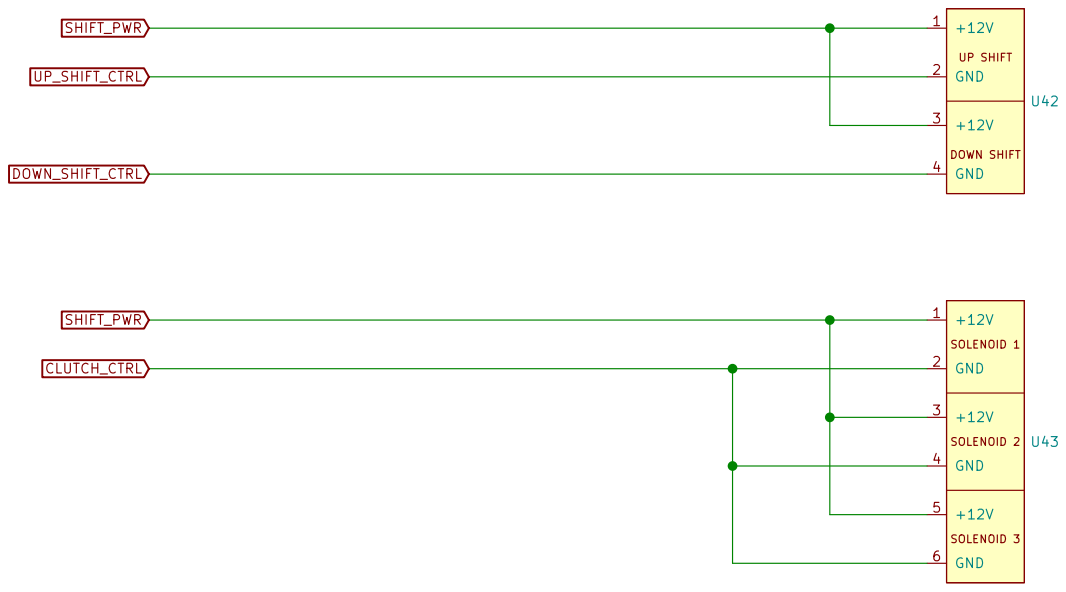
[picture p19: page 15]

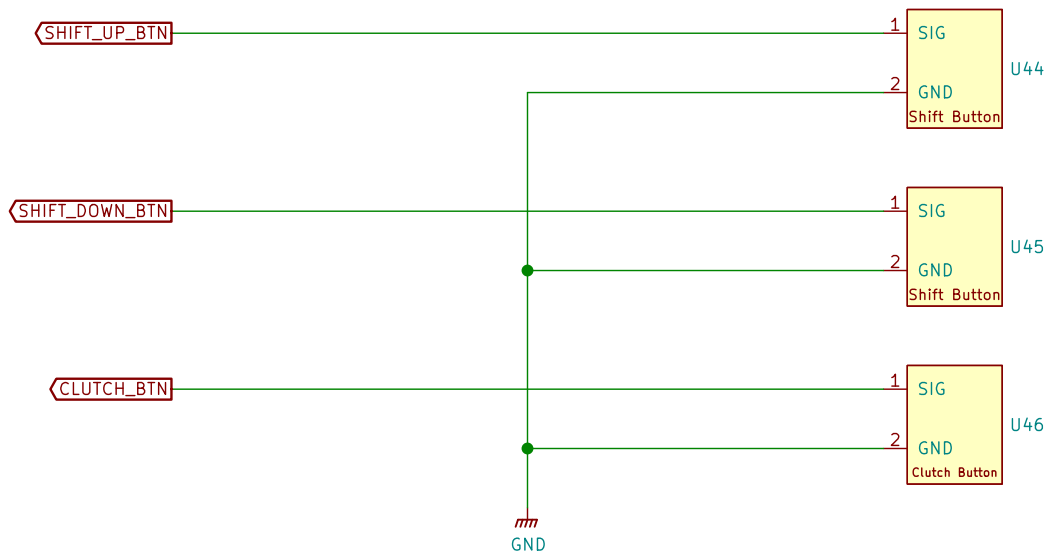
[picture p20: page 16]

File: F20_Steering.sch
Id: 16/18 Title: Steering Wheel

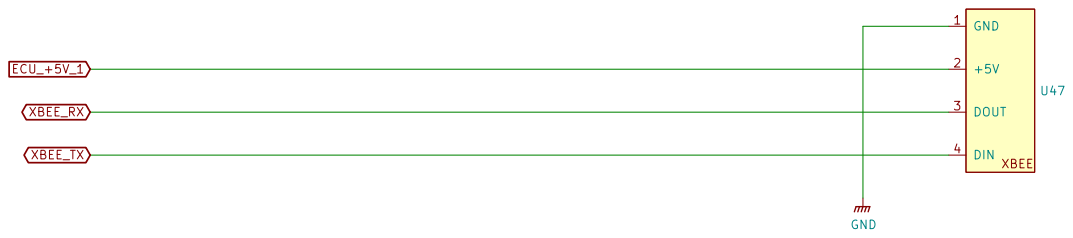
[picture p21: page 17]

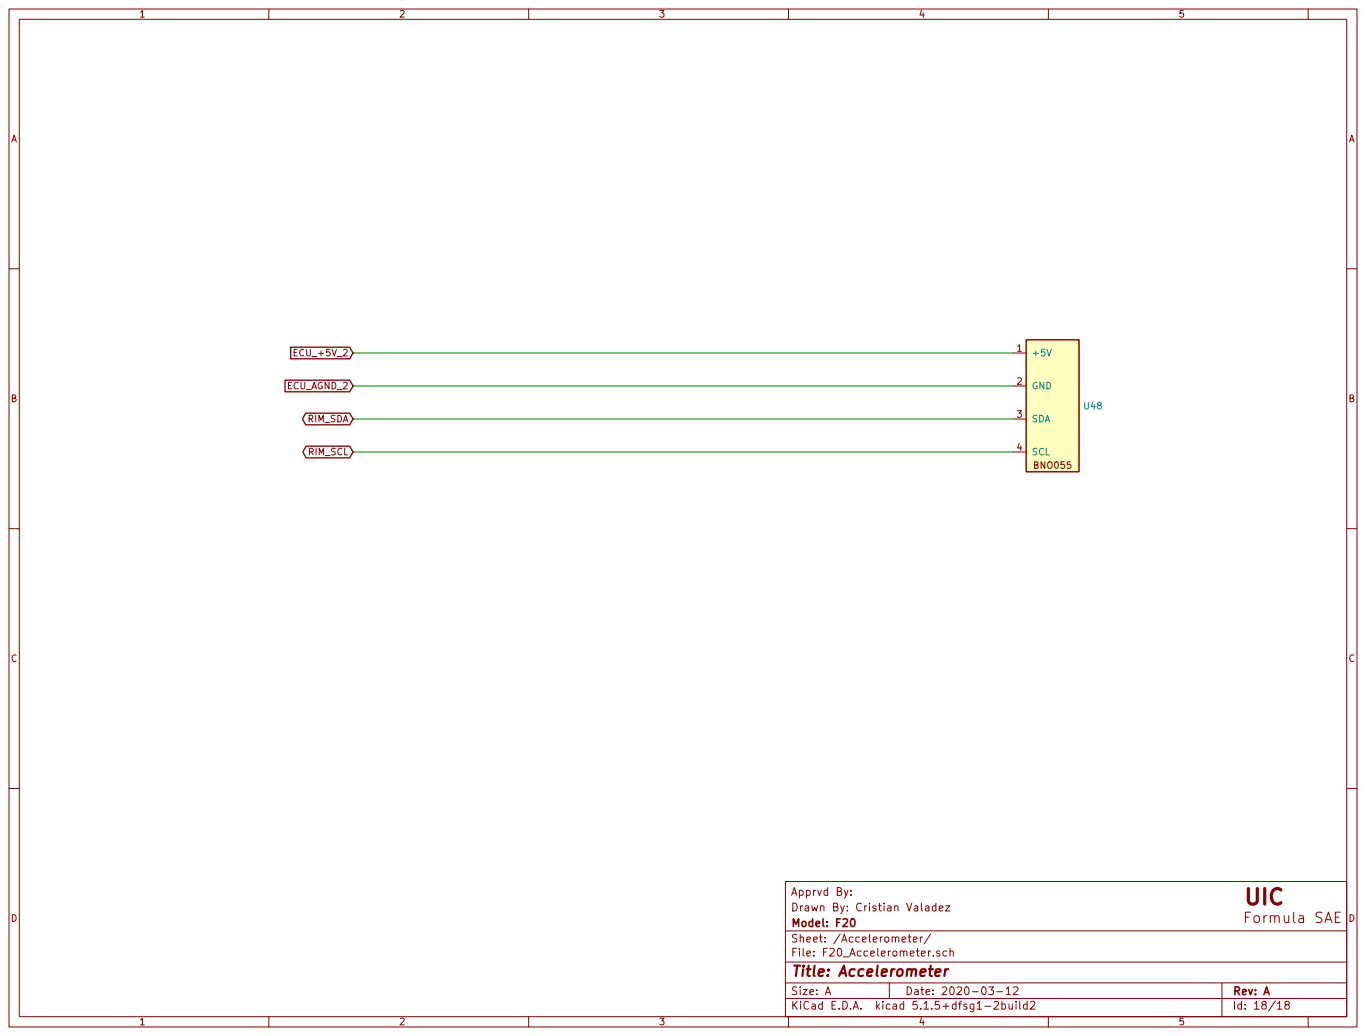
[picture p22: page 18]
