CValadez94/F20_Schematics/Schematics/F20_Logic_Diagrams/F20_ROOT/F20_Brakes.sch

## KiCad design Schematics/F20_Logic_Diagrams/F20_ROOT/F20_Brakes.sch (2020-10-02)

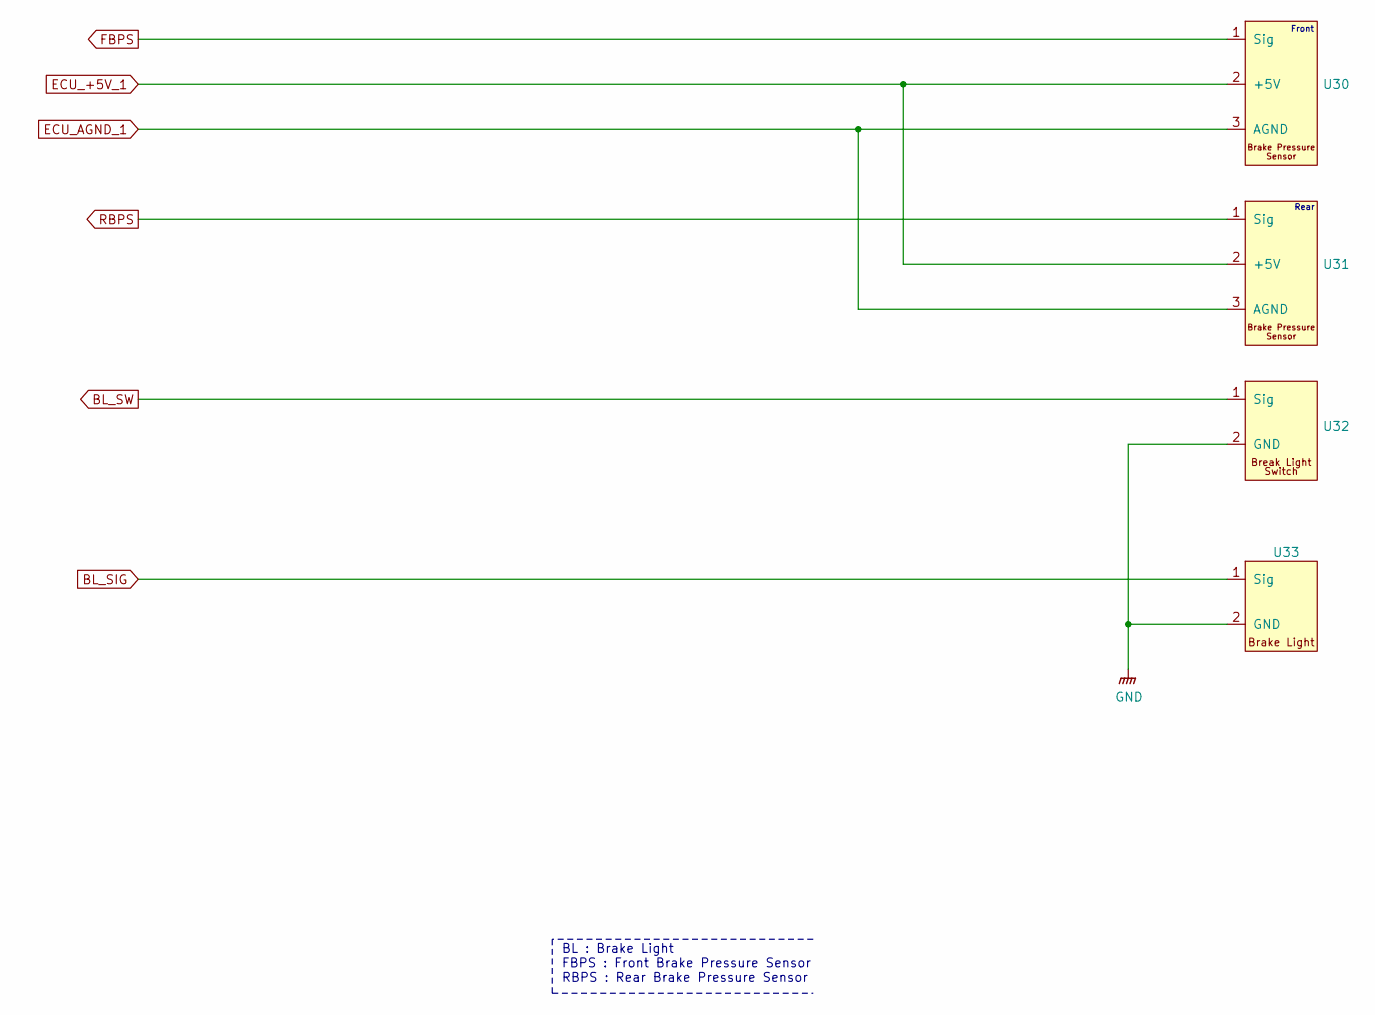
[picture p23: schematic F20_Brakes.sch]

Parts:
U30, U31: Brake_Pressure_Sensor
U32: Brake_Light_Switch
U33: Brake_Light

Connections:
BL_SIG: U33.1 (Sig)
BL_SW: U32.1 (Sig)
ECU_+5V_1: U30.2 (+5V), U31.2 (+5V)
ECU_AGND_1: U30.3 (AGND), U31.3 (AGND)
FBPS: U30.1 (Sig)
GND: U32.2 (GND), U33.2 (GND)
RBPS: U31.1 (Sig)

Notes on the sheet:
Rear
Front
BL : Brake Light FBPS : Front Brake Pressure Sensor RBPS : Rear Brake Pressure Sensor
