CValadez94/F20_Schematics/Schematics/F20_Logic_Diagrams/F20_ROOT/F20_Coils.sch

## KiCad design Schematics/F20_Logic_Diagrams/F20_ROOT/F20_Coils.sch (2020-10-02)

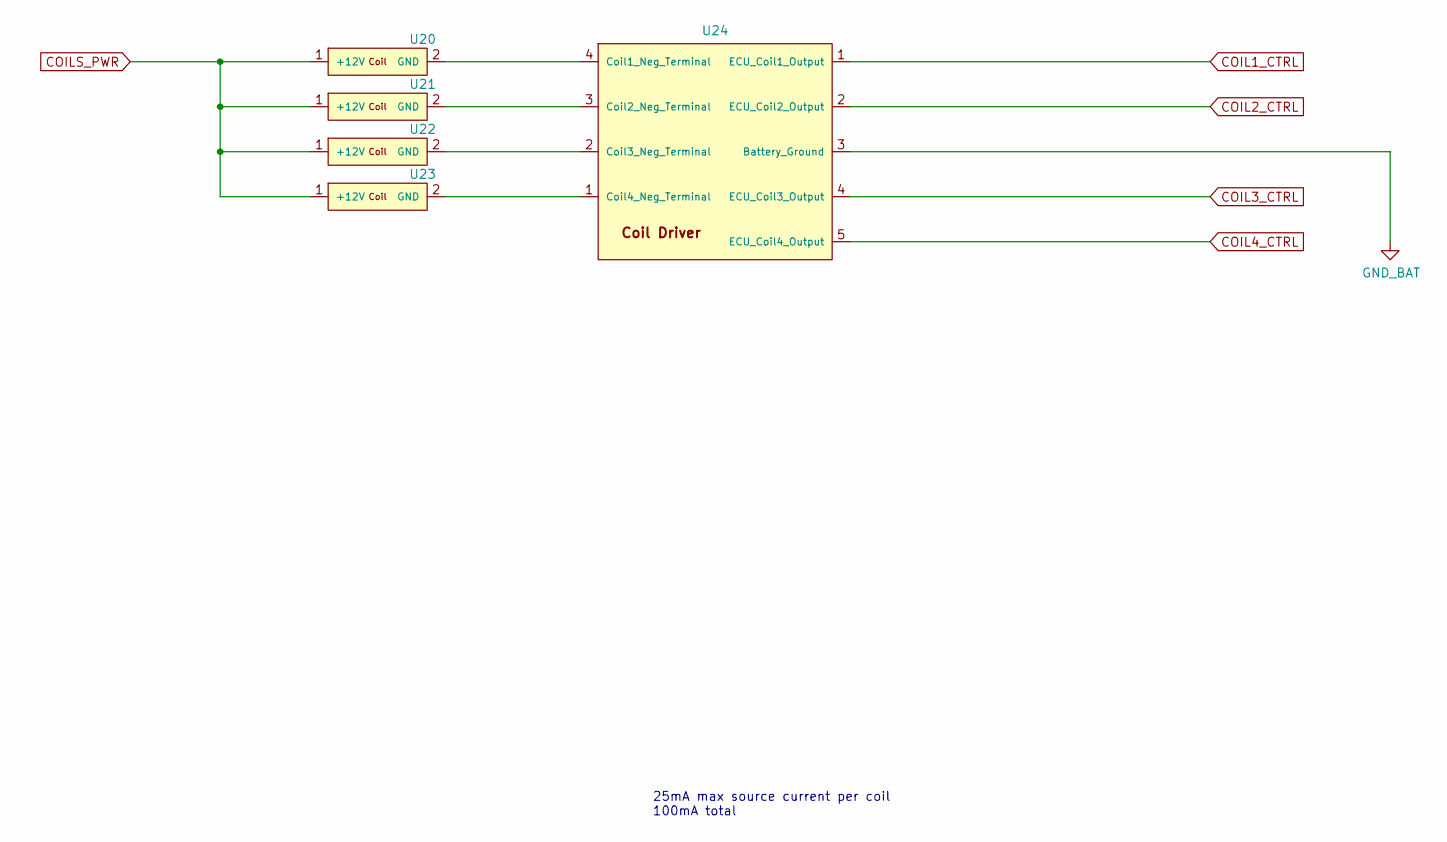
[picture p24: schematic F20_Coils.sch]

Parts:
U20, U21, U22, U23: Ignition_Coil
U24: Coil_Driver

Connections:
COIL1_CTRL: U24.1 (Coil4_Neg_Terminal)
COIL2_CTRL: U24.2 (Coil3_Neg_Terminal)
COIL3_CTRL: U24.4 (Coil1_Neg_Terminal)
COIL4_CTRL: U24.5 (ECU_Coil4_Output)
COILS_PWR: U20.1 (+12V), U21.1 (+12V), U22.1 (+12V), U23.1 (+12V)
GND_BAT: U24.3 (Battery_Ground)
unnamed: U20.2 (GND), U24.4 (Coil1_Neg_Terminal)
unnamed: U21.2 (GND), U24.3 (Battery_Ground)
unnamed: U22.2 (GND), U24.2 (Coil3_Neg_Terminal)
unnamed: U23.2 (GND), U24.1 (Coil4_Neg_Terminal)

Notes on the sheet:
25mA max source current per coil 100mA total
