CValadez94/F20_Schematics/Schematics/F20_Logic_Diagrams/F20_ROOT/F20_Injectors.sch

## KiCad design Schematics/F20_Logic_Diagrams/F20_ROOT/F20_Injectors.sch (2020-10-02)

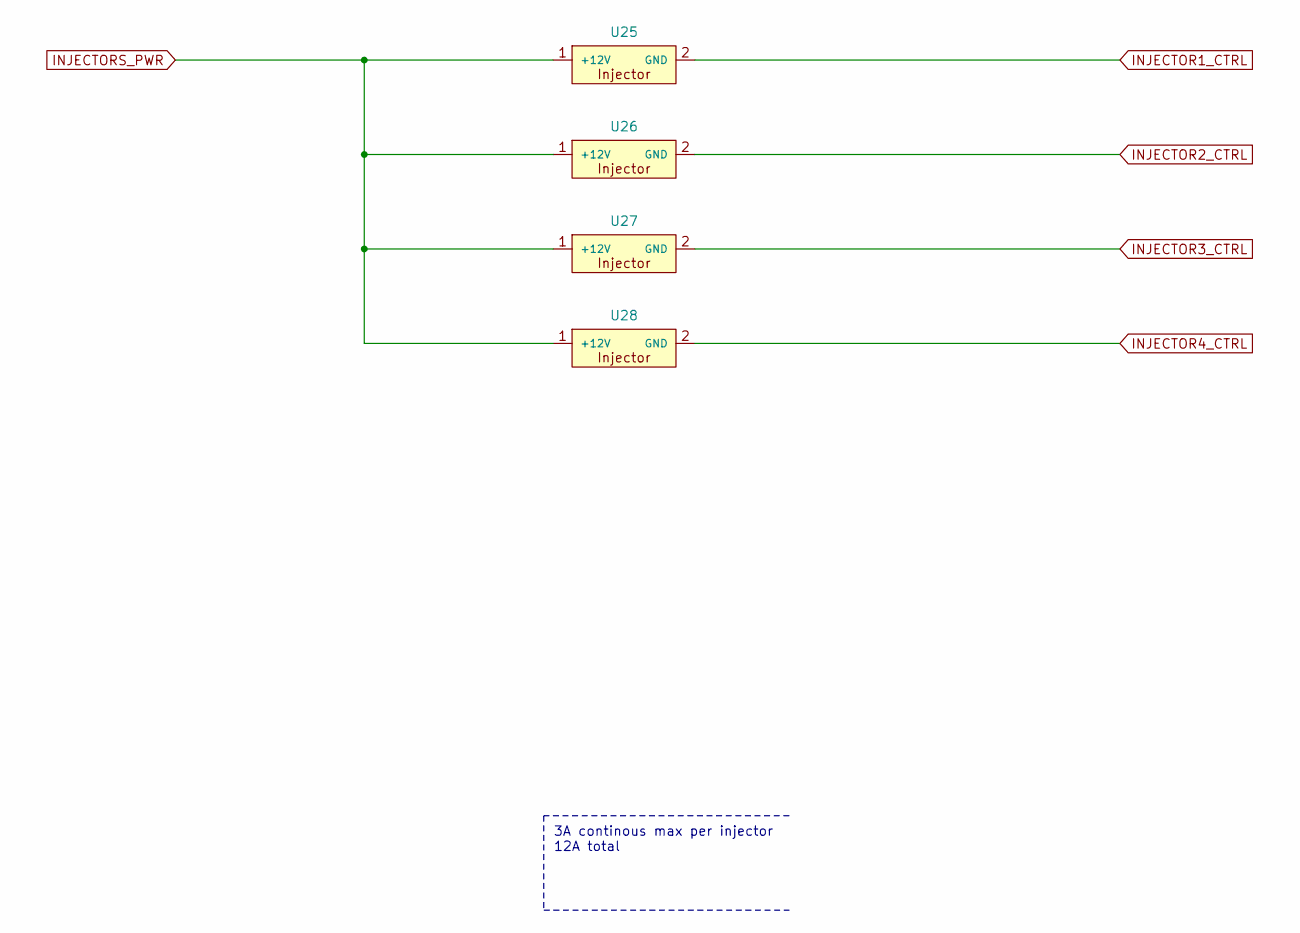
[picture p25: schematic F20_Injectors.sch]

Parts:
U25, U26, U27, U28: Injector

Connections:
INJECTOR1_CTRL: U25.2 (GND)
INJECTOR2_CTRL: U26.2 (GND)
INJECTOR3_CTRL: U27.2 (GND)
INJECTOR4_CTRL: U28.2 (GND)
INJECTORS_PWR: U25.1 (+12V), U26.1 (+12V), U27.1 (+12V), U28.1 (+12V)

Notes on the sheet:
3A continous max per injector 12A total
