CValadez94/F20_Schematics/Schematics/F20_Logic_Diagrams/F20_ROOT/F20_O2_Sensor.sch

## KiCad design Schematics/F20_Logic_Diagrams/F20_ROOT/F20_O2_Sensor.sch (2020-10-02)

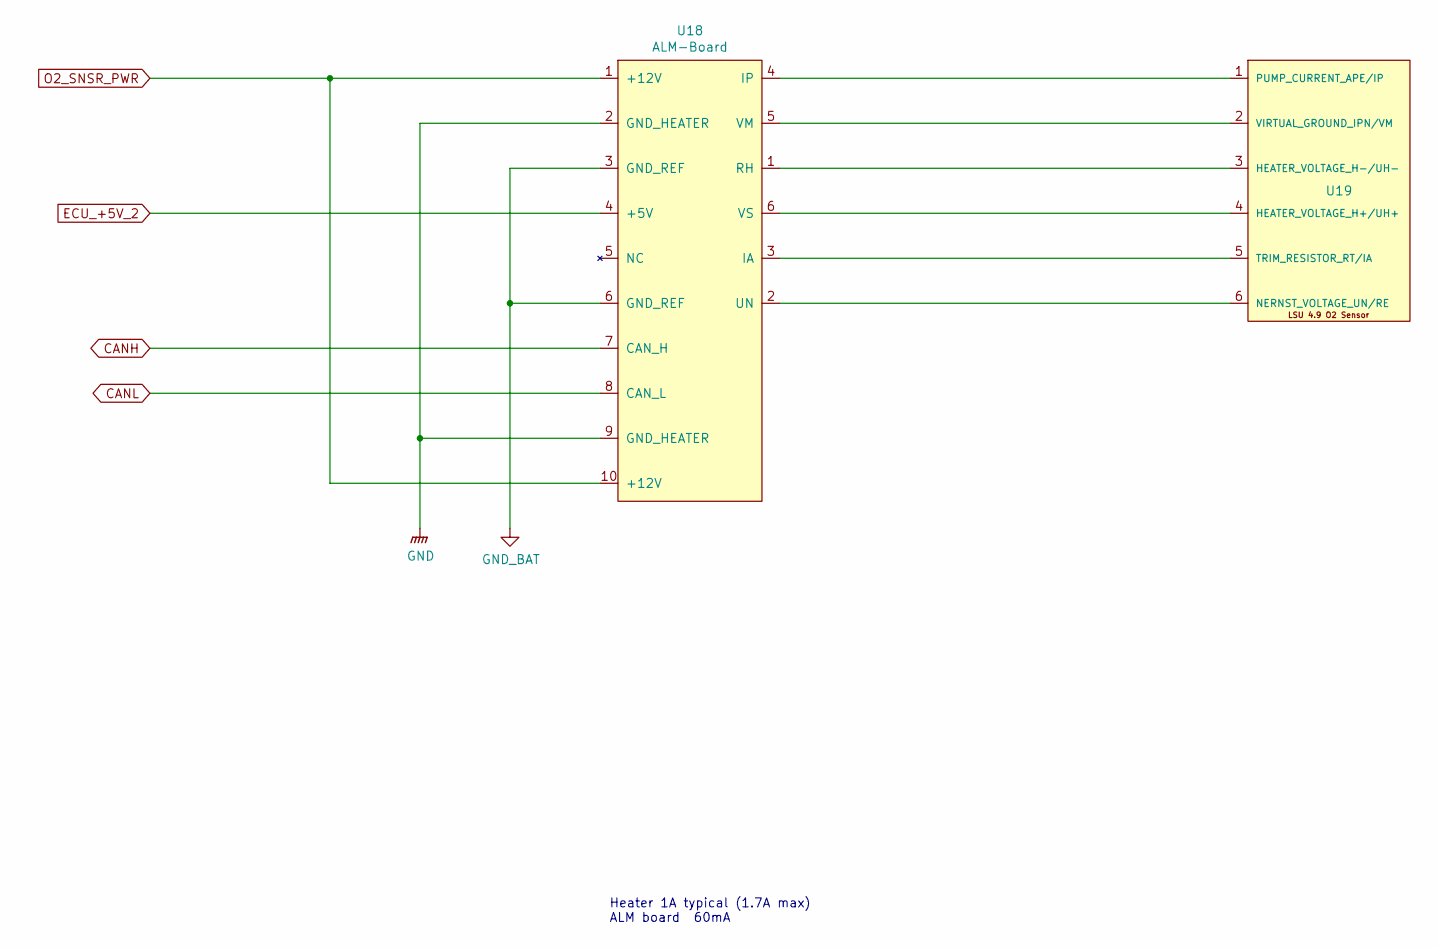
[picture p26: schematic F20_O2_Sensor.sch]

Parts:
U18: ALM
U19: O2_Sensor

Connections:
CANH: U18.7 (CAN_H)
CANL: U18.8 (CAN_L)
ECU_+5V_2: U18.4 (+5V)
GND: U18.2 (GND_HEATER), U18.9 (GND_HEATER)
GND_BAT: U18.3 (GND_REF), U18.6 (GND_REF)
unnamed: U18.1 (+12V), U19.3 (HEATER_VOLTAGE_H-/UH-)
unnamed: U18.2 (GND_HEATER), U19.6 (NERNST_VOLTAGE_UN/RE)
unnamed: U18.3 (GND_REF), U19.5 (TRIM_RESISTOR_RT/IA)
unnamed: U18.4 (+5V), U19.1 (PUMP_CURRENT_APE/IP)
unnamed: U18.5 (NC), U19.2 (VIRTUAL_GROUND_IPN/VM)
unnamed: U18.6 (GND_REF), U19.4 (HEATER_VOLTAGE_H+/UH+)
O2_SNSR_PWR: U18.1 (+12V), U18.10 (+12V)

Notes on the sheet:
Heater 1A typical (1.7A max) ALM board ~ 60mA
