CValadez94/F20_Schematics/Schematics/F20_Logic_Diagrams/F20_ROOT/F20_Power_Management.sch

## KiCad design Schematics/F20_Logic_Diagrams/F20_ROOT/F20_Power_Management.sch (2020-10-02)

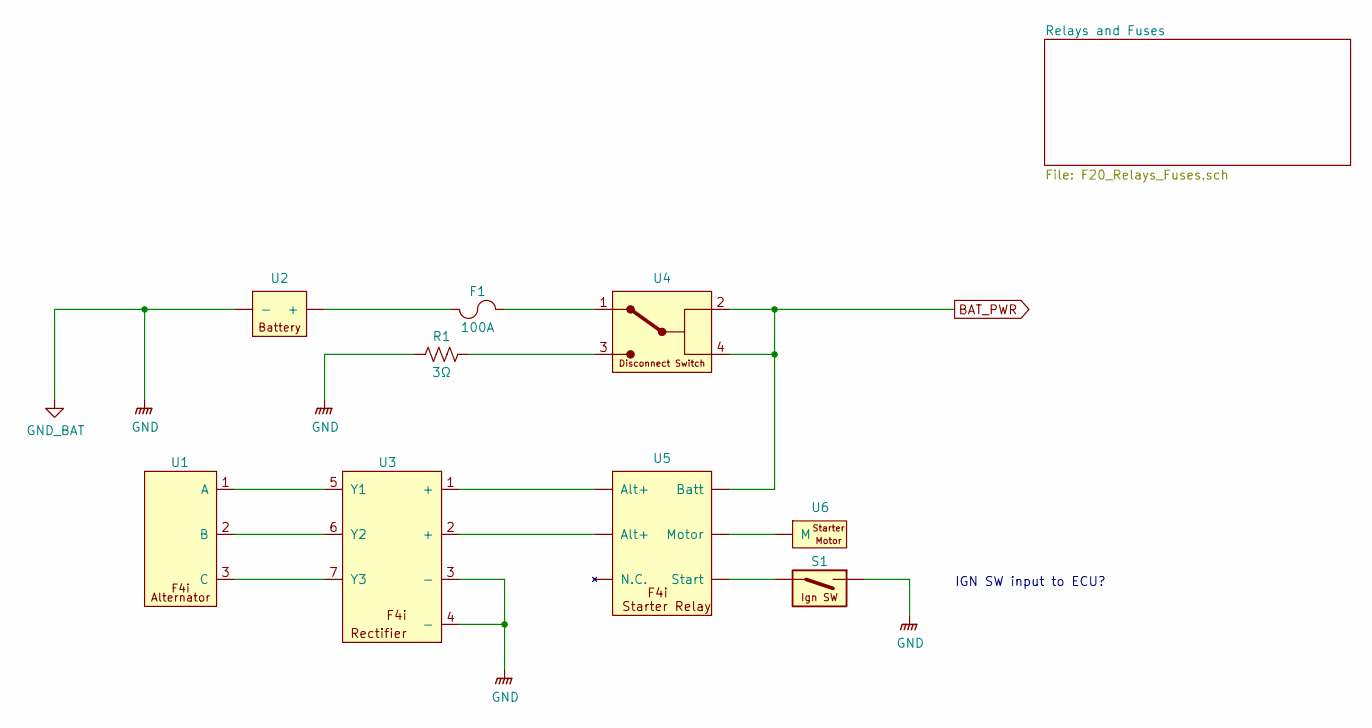
[picture p27: schematic F20_Power_Management.sch]

Parts:
F1: 100A
R1: 3Ω
S1: Ignition_SW
U1: Alternator
U2: Battery
U3: Rectifier
U4: Cutoff_Switch
U5: Starter_Relay
U6: Starter_Motor

Connections:
BAT_PWR: U4.2, U4.4, U5.~
GND: R1.2, S1.~, U2.~, U3.3 (-), U3.4 (-)
unnamed: F1.1, U2.~
unnamed: F1.2, U4.1
unnamed: R1.1, U4.3
unnamed: S1.~, U5.~
unnamed: U1.1 (A), U3.5 (Y1)
unnamed: U1.2 (B), U3.6 (Y2)
unnamed: U1.3 (C), U3.7 (Y3)
unnamed: U3.1 (+), U5.~
unnamed: U3.2 (+), U5.~
unnamed: U5.~, U6.~

Notes on the sheet:
IGN SW input to ECU?
