CValadez94/F20_Schematics/Schematics/F20_Logic_Diagrams/F20_ROOT/F20_Powertrain.sch

## KiCad design Schematics/F20_Logic_Diagrams/F20_ROOT/F20_Powertrain.sch (2020-10-02)

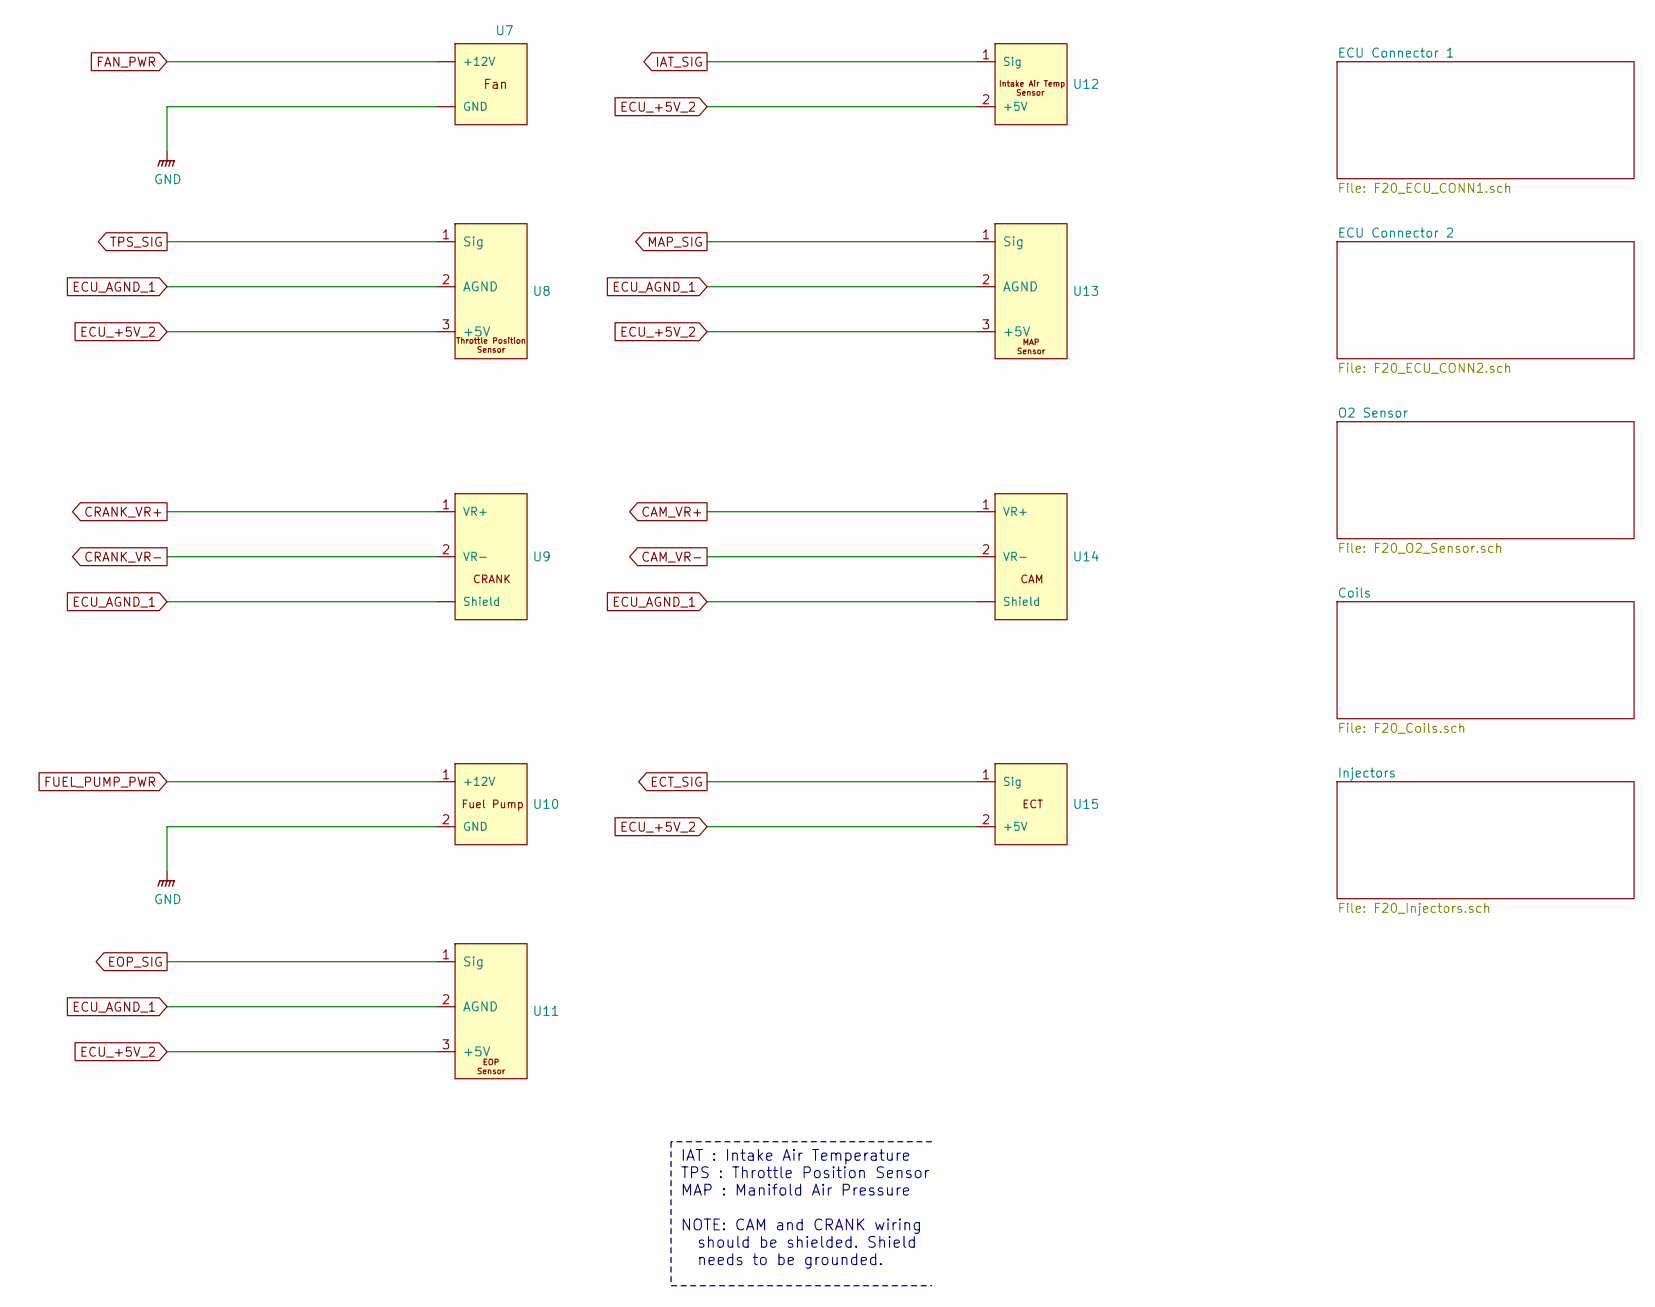
[picture p28: schematic F20_Powertrain.sch]

Parts:
U7: Fan
U8: Throttle_Position_Sensor
U9: Crankshaft_Sensor
U10: Fuel_Pump
U11: EOP_Sensor
U12: Intake_Air_Temp
U13: MAP_Sensor
U14: Camshaft_Sensor
U15: ECT_Sensor

Connections:
CAM_VR+: U14.1 (VR+)
CAM_VR-: U14.2 (VR-)
CRANK_VR+: U9.1 (VR+)
CRANK_VR-: U9.2 (VR-)
ECT_SIG: U15.1 (Sig)
ECU_+5V_2: U8.3 (+5V), U11.3 (+5V), U12.2 (+5V), U13.3 (+5V), U15.2 (+5V)
ECU_AGND_1: U8.2 (AGND), U9.~ (Shield), U11.2 (AGND), U13.2 (AGND), U14.~ (Shield)
EOP_SIG: U11.1 (Sig)
FAN_PWR: U7.~
FUEL_PUMP_PWR: U10.1 (+12V)
GND: U7.~, U10.2 (GND)
IAT_SIG: U12.1 (Sig)
MAP_SIG: U13.1 (Sig)
TPS_SIG: U8.1 (Sig)

Notes on the sheet:
IAT : Intake Air Temperature TPS : Throttle Position Sensor MAP : Manifold Air Pressure NOTE: CAM and CRANK wiring should be shielded. Shield needs to be grounded.
