CValadez94/F20_Schematics/Schematics/F20_Logic_Diagrams/F20_ROOT/F20_RIM.sch

## KiCad design Schematics/F20_Logic_Diagrams/F20_ROOT/F20_RIM.sch (2020-10-02)

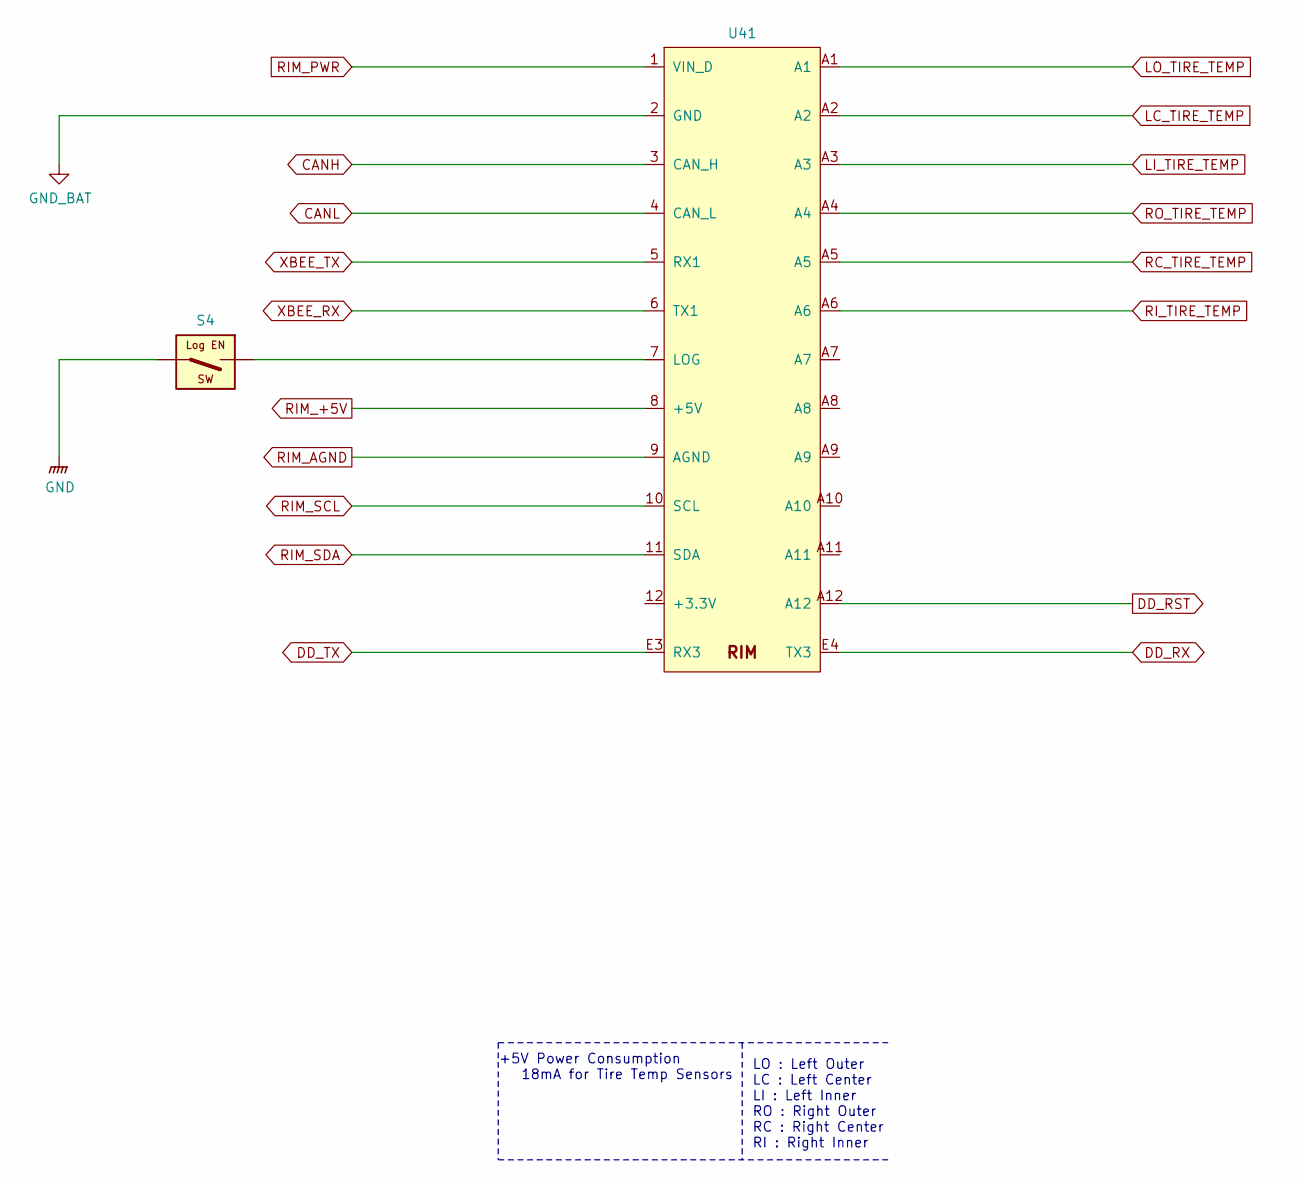
[picture p29: schematic F20_RIM.sch]

Parts:
S4: LOG_EN_SW
U41: RIM

Connections:
CANH: U41.3 (CAN_H)
CANL: U41.4 (CAN_L)
DD_RST: U41.A12
DD_RX: U41.E4 (TX3)
DD_TX: U41.E3 (RX3)
GND: S4.~
GND_BAT: U41.2 (GND)
LC_TIRE_TEMP: U41.A2
LI_TIRE_TEMP: U41.A3
LO_TIRE_TEMP: U41.A1
unnamed: S4.~, U41.7 (LOG)
RC_TIRE_TEMP: U41.A5
RIM_+5V: U41.8 (+5V)
RIM_AGND: U41.9 (AGND)
RIM_PWR: U41.1 (VIN_D)
RIM_SCL: U41.10 (SCL)
RIM_SDA: U41.11 (SDA)
RI_TIRE_TEMP: U41.A6
RO_TIRE_TEMP: U41.A4
XBEE_RX: U41.6 (TX1)
XBEE_TX: U41.5 (RX1)

Notes on the sheet:
LO : Left Outer LC : Left Center LI : Left Inner RO : Right Outer RC : Right Center RI : Right Inner
+5V Power Consumption 18mA for Tire Temp Sensors
