CValadez94/F20_Schematics/Schematics/F20_Logic_Diagrams/F20_ROOT/F20_Relays_Fuses.sch

## KiCad design Schematics/F20_Logic_Diagrams/F20_ROOT/F20_Relays_Fuses.sch (2020-10-02)

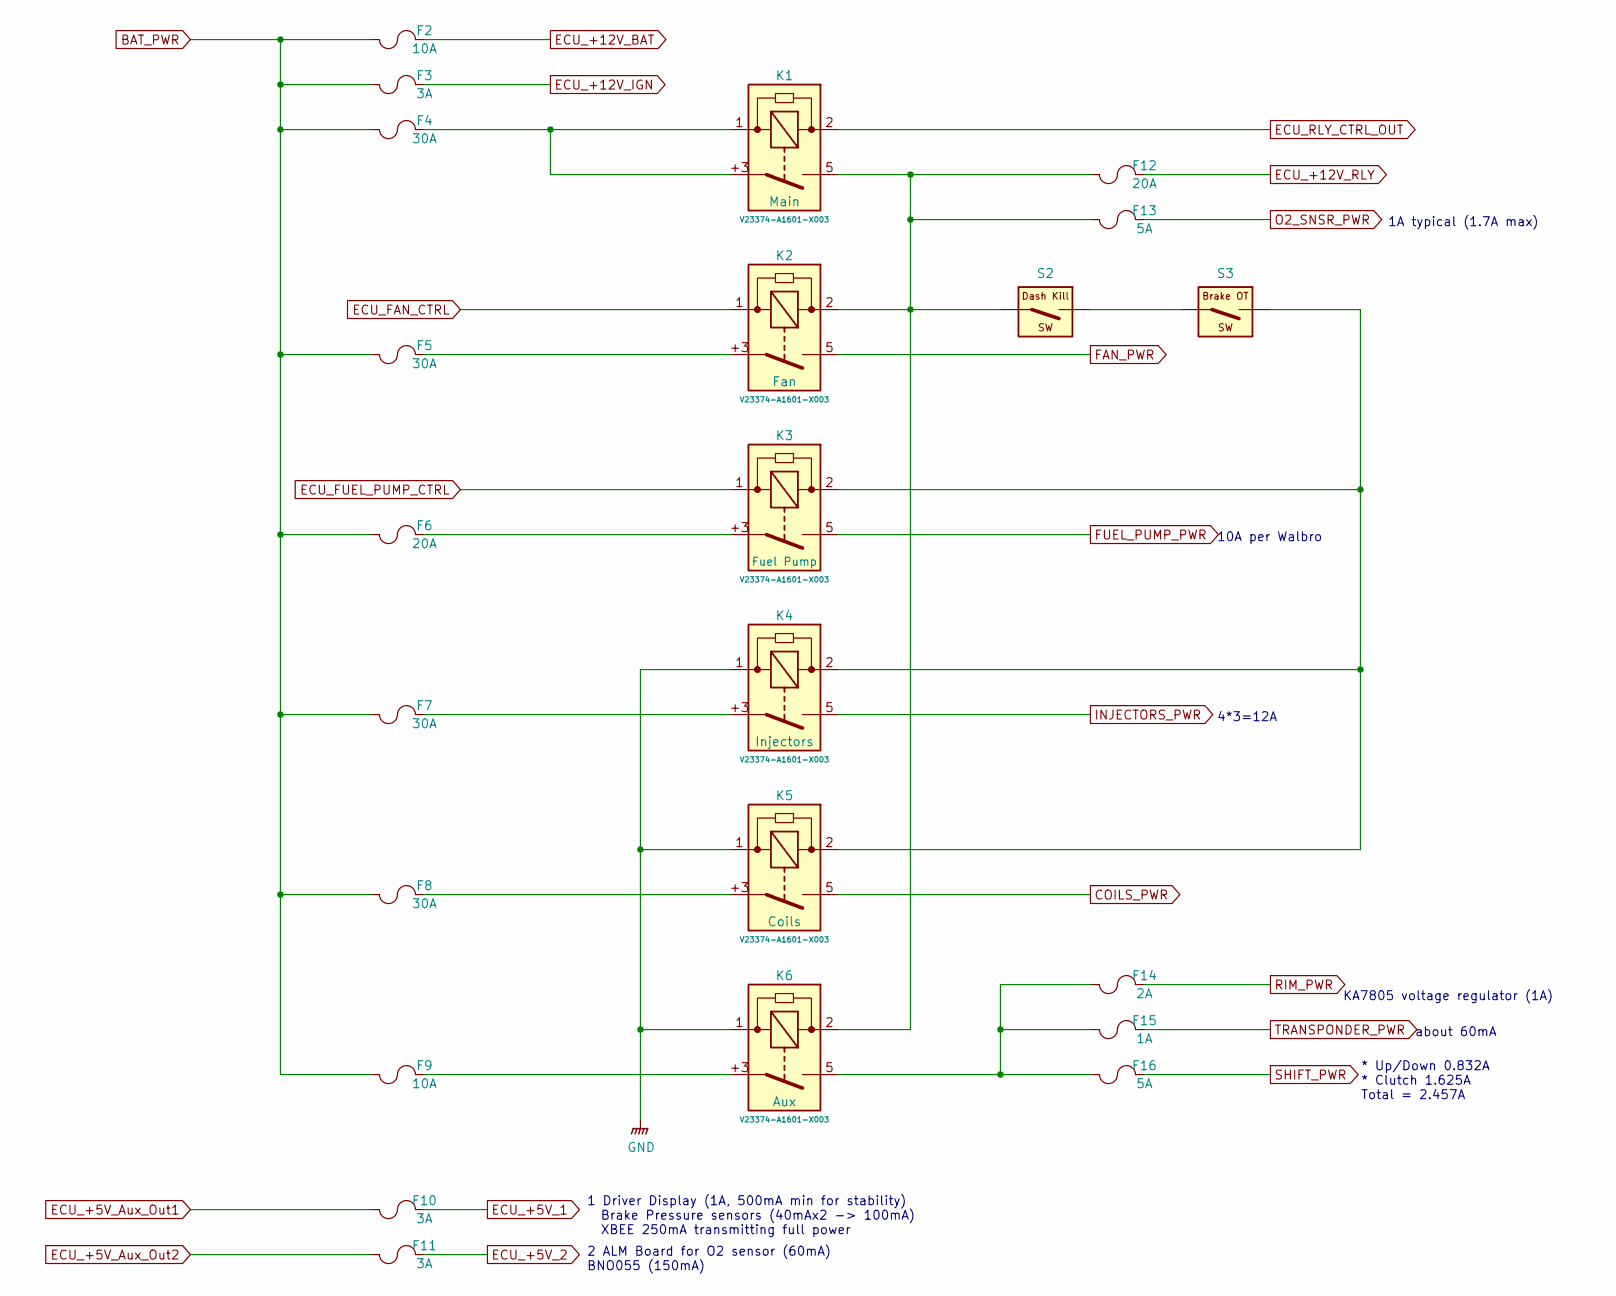
[picture p30: schematic F20_Relays_Fuses.sch]

Parts:
F2, F9: 10A
F3, F10, F11: 3A
F4, F5, F7, F8: 30A
F6, F12: 20A
F13, F16: 5A
F14: 2A
F15: 1A
K1, K2, K3, K4, K5, K6: MicroRelay
S2: Dash_Kill_SW
S3: Bake_OT_SW

Connections:
BAT_PWR: F2.1, F3.1, F4.1, F5.1, F6.1, F7.1, F8.1, F9.1
COILS_PWR: K5.5
ECU_+5V_1: F10.2
ECU_+5V_2: F11.2
ECU_+5V_Aux_Out1: F10.1
ECU_+5V_Aux_Out2: F11.1
ECU_+12V_BAT: F2.2
ECU_+12V_IGN: F3.2
ECU_+12V_RLY: F12.2
ECU_FAN_CTRL: K2.1
ECU_FUEL_PUMP_CTRL: K3.1
ECU_RLY_CTRL_OUT: K1.2
FAN_PWR: K2.5
FUEL_PUMP_PWR: K3.5
GND: K4.1, K5.1, K6.1
INJECTORS_PWR: K4.5
unnamed: F4.2, K1.1, K1.+3
unnamed: F5.2, K2.+3
unnamed: F6.2, K3.+3
unnamed: F7.2, K4.+3
unnamed: F8.2, K5.+3
unnamed: F9.2, K6.+3
unnamed: F12.1, F13.1, K1.5, K2.2, K6.2, S2.~
unnamed: F14.1, F15.1, F16.1, K6.5
unnamed: K3.2, K4.2, K5.2, S3.~
unnamed: S2.~, S3.~
O2_SNSR_PWR: F13.2
RIM_PWR: F14.2
SHIFT_PWR: F16.2
TRANSPONDER_PWR: F15.2

Notes on the sheet:
1A typical (1.7A max)
KA7805 voltage regulator (1A)
about 60mA
1 Driver Display (1A, 500mA min for stability) Brake Pressure sensors (40mAx2 -> 100mA) XBEE 250mA transmitting full power
10A per Walbro
* Up/Down 0.832A * Clutch 1.625A Total = 2.457A
4*3=12A
2 ALM Board for O2 sensor (60mA) BNO055 (150mA)
