CValadez94/F20_Schematics/Schematics/F20_Logic_Diagrams/F20_ROOT/F20_Shifter.sch

## KiCad design Schematics/F20_Logic_Diagrams/F20_ROOT/F20_Shifter.sch (2020-10-02)

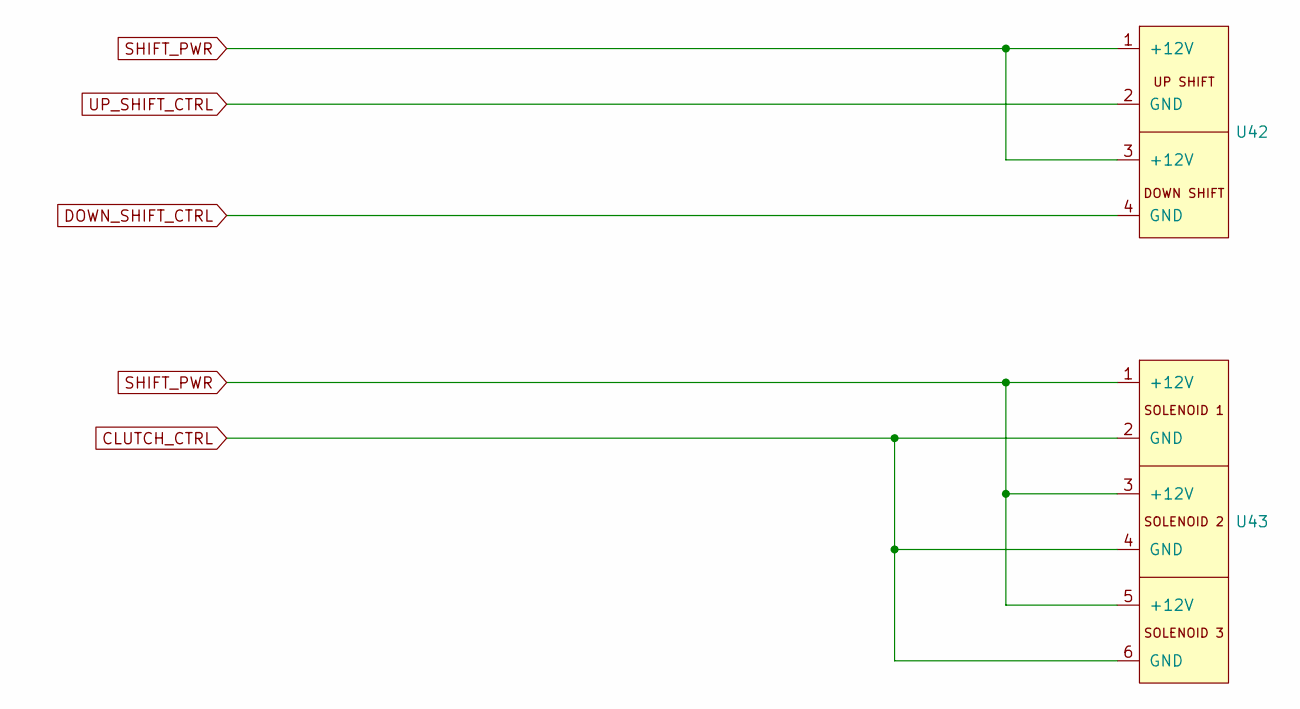
[picture p31: schematic F20_Shifter.sch]

Parts:
U42: Up_Down_Shifter
U43: Clutch_Actuator

Connections:
CLUTCH_CTRL: U43.2 (GND), U43.4 (GND), U43.6 (GND)
DOWN_SHIFT_CTRL: U42.4 (GND)
SHIFT_PWR: U42.1 (+12V), U42.3 (+12V), U43.1 (+12V), U43.3 (+12V), U43.5 (+12V)
UP_SHIFT_CTRL: U42.2 (GND)
