CValadez94/F20_Schematics/Schematics/F20_Logic_Diagrams/F20_ROOT/F20_Steering.sch

## KiCad design Schematics/F20_Logic_Diagrams/F20_ROOT/F20_Steering.sch (2020-10-02)

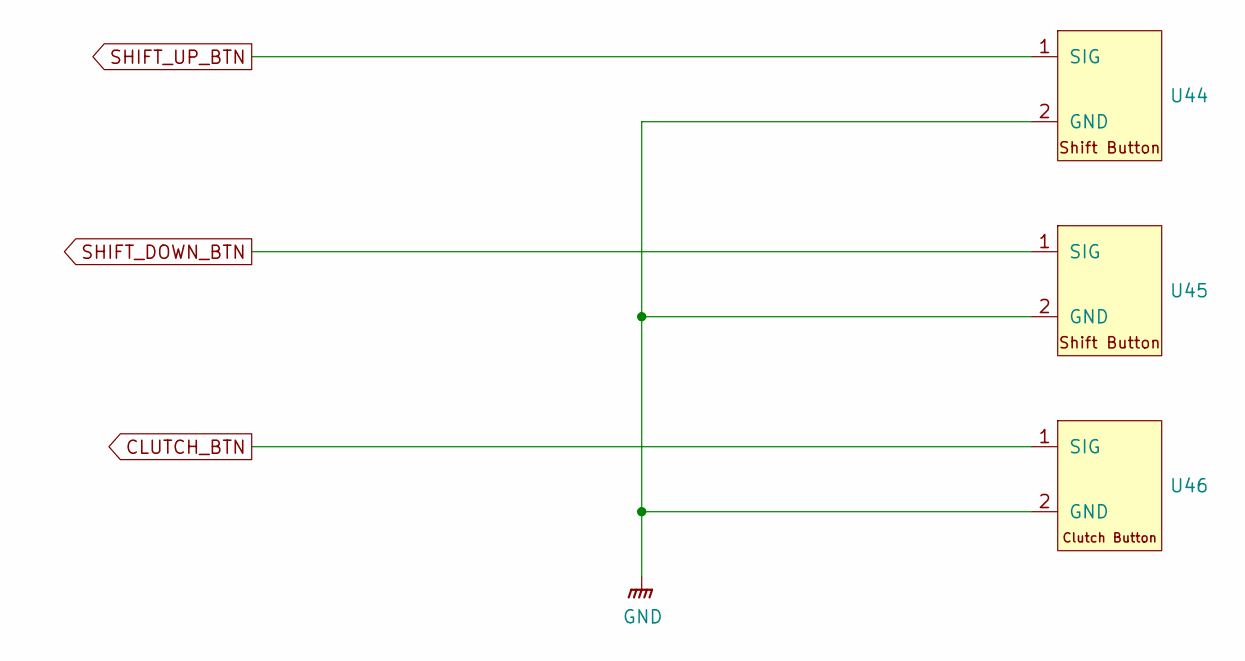
[picture p32: schematic F20_Steering.sch]

Parts:
U44, U45: ShiftButton
U46: ClutchButton

Connections:
CLUTCH_BTN: U46.1 (SIG)
GND: U44.2 (GND), U45.2 (GND), U46.2 (GND)
SHIFT_DOWN_BTN: U45.1 (SIG)
SHIFT_UP_BTN: U44.1 (SIG)
