CValadez94/F20_Schematics/Schematics/F20_Logic_Diagrams/F20_ROOT/F20_Tire_Temp_Sensors.sch

## KiCad design Schematics/F20_Logic_Diagrams/F20_ROOT/F20_Tire_Temp_Sensors.sch (2020-10-02)

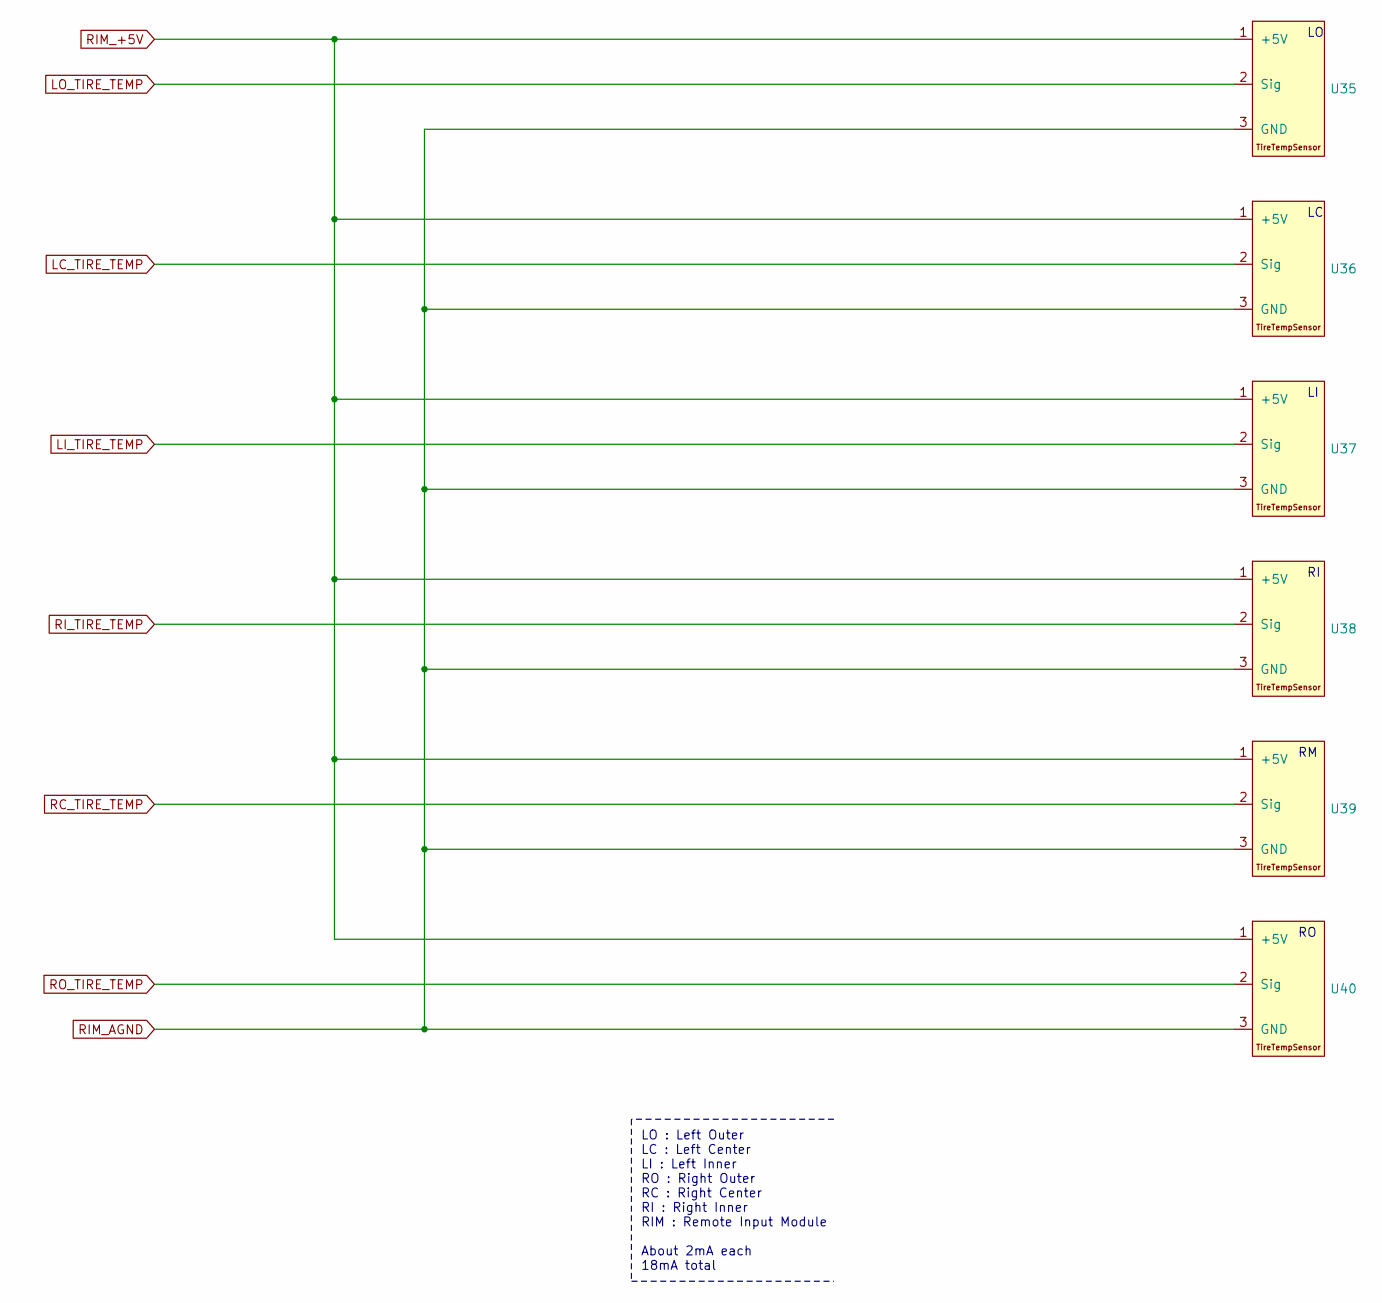
[picture p33: schematic F20_Tire_Temp_Sensors.sch]

Parts:
U35, U36, U37, U38, U39, U40: Tire_Temp_Sensor

Connections:
LC_TIRE_TEMP: U36.2 (Sig)
LI_TIRE_TEMP: U37.2 (Sig)
LO_TIRE_TEMP: U35.2 (Sig)
RC_TIRE_TEMP: U39.2 (Sig)
RIM_+5V: U35.1 (+5V), U36.1 (+5V), U37.1 (+5V), U38.1 (+5V), U39.1 (+5V), U40.1 (+5V)
RIM_AGND: U35.3 (GND), U36.3 (GND), U37.3 (GND), U38.3 (GND), U39.3 (GND), U40.3 (GND)
RI_TIRE_TEMP: U38.2 (Sig)
RO_TIRE_TEMP: U40.2 (Sig)

Notes on the sheet:
LO : Left Outer LC : Left Center LI : Left Inner RO : Right Outer RC : Right Center RI : Right Inner RIM : Remote Input Module About 2mA each 18mA total
