CValadez94/F20_Schematics/Schematics/F20_Wiring_Diagrams/F20_ROOT_WIRING/F20_W_Cab_PowerManagement.sch

## KiCad design Schematics/F20_Wiring_Diagrams/F20_ROOT_WIRING/F20_W_Cab_PowerManagement.sch (2020-10-07)

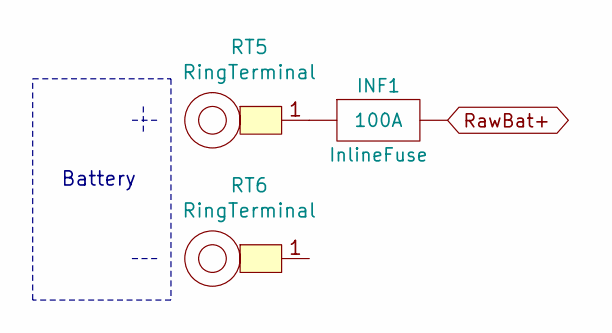
[picture p34: schematic F20_W_Cab_PowerManagement.sch]

Parts:
INF1: InlineFuse; Rating 100A
RT5, RT6: RingTerminal

Connections:
unnamed: INF1.~, RT5.1
RawBat+: INF1.~

Notes on the sheet:
Battery
