CValadez94/F20_Schematics/Schematics/F20_Wiring_Diagrams/F20_ROOT_WIRING/F20_W_Eng_PowerManagement.sch

## KiCad design Schematics/F20_Wiring_Diagrams/F20_ROOT_WIRING/F20_W_Eng_PowerManagement.sch (2020-10-07)

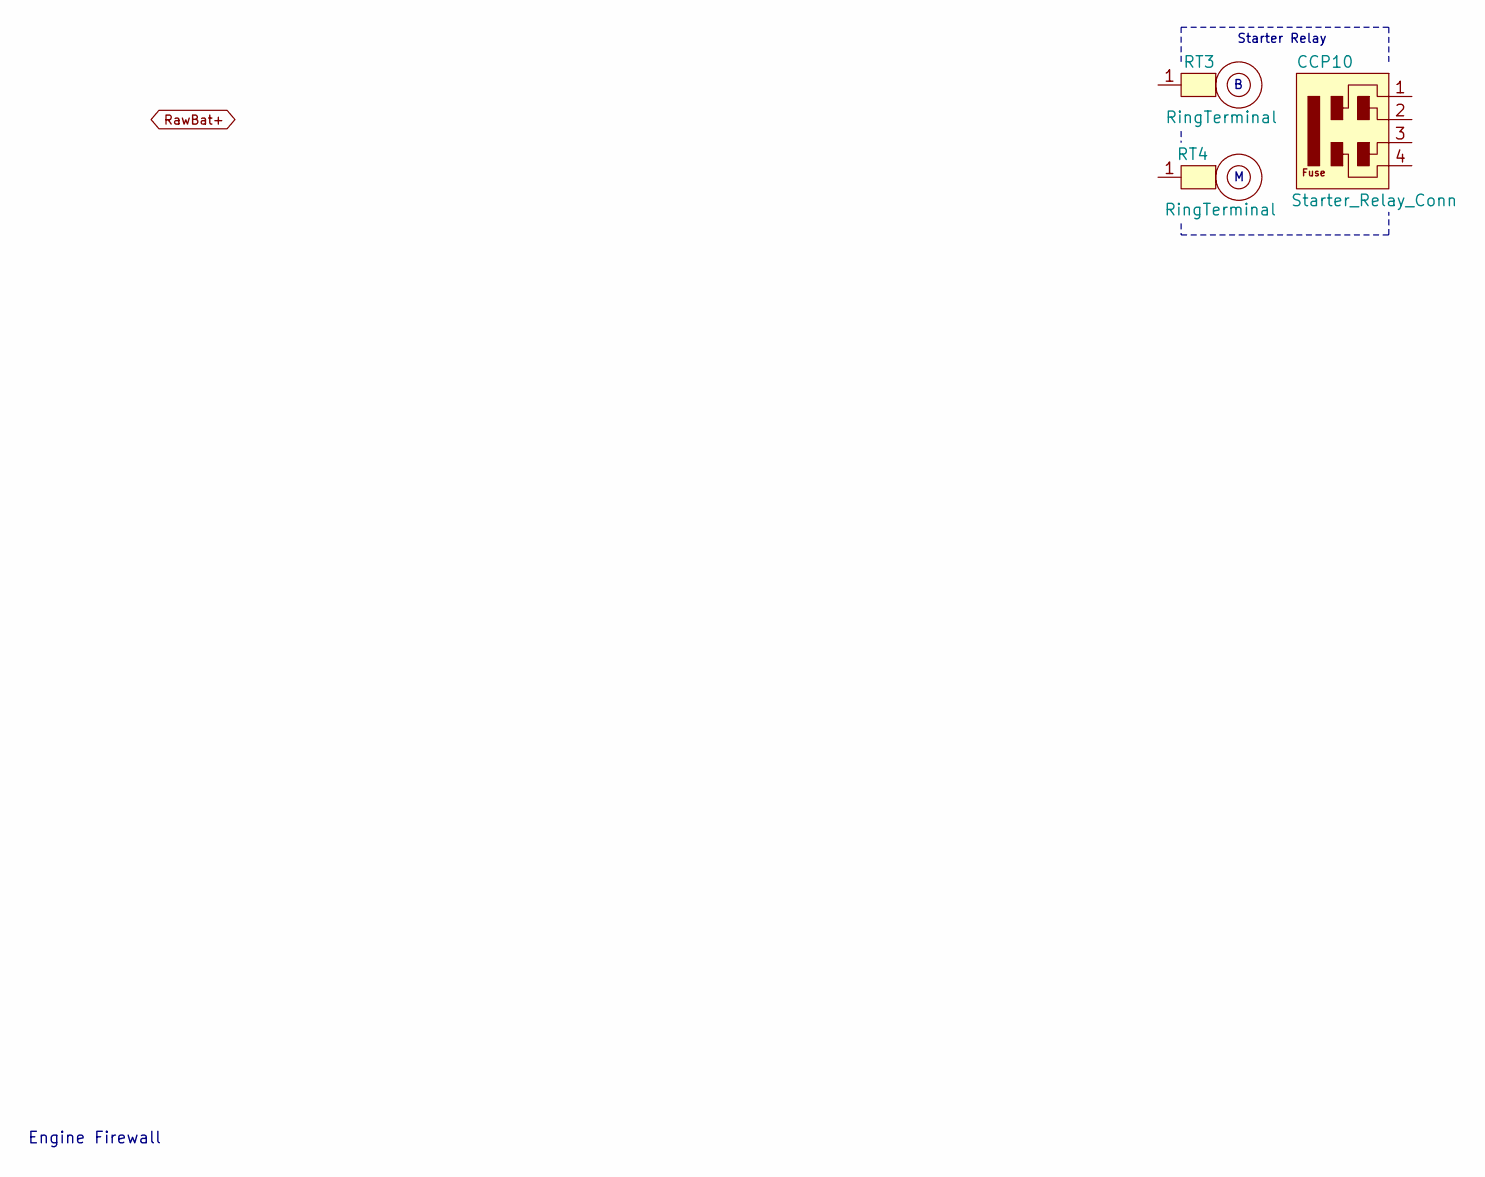
[picture p35: schematic F20_W_Eng_PowerManagement.sch]

Parts:
CCP10: Starter_Relay_Conn
RT3, RT4: RingTerminal

Notes on the sheet:
Engine Firewall
Starter Relay
