CValadez94/F20_Schematics/Schematics/F20_Wiring_Diagrams/F20_ROOT_WIRING/F20_W_Eng_Sensors.sch

## KiCad design Schematics/F20_Wiring_Diagrams/F20_ROOT_WIRING/F20_W_Eng_Sensors.sch (2020-10-07)

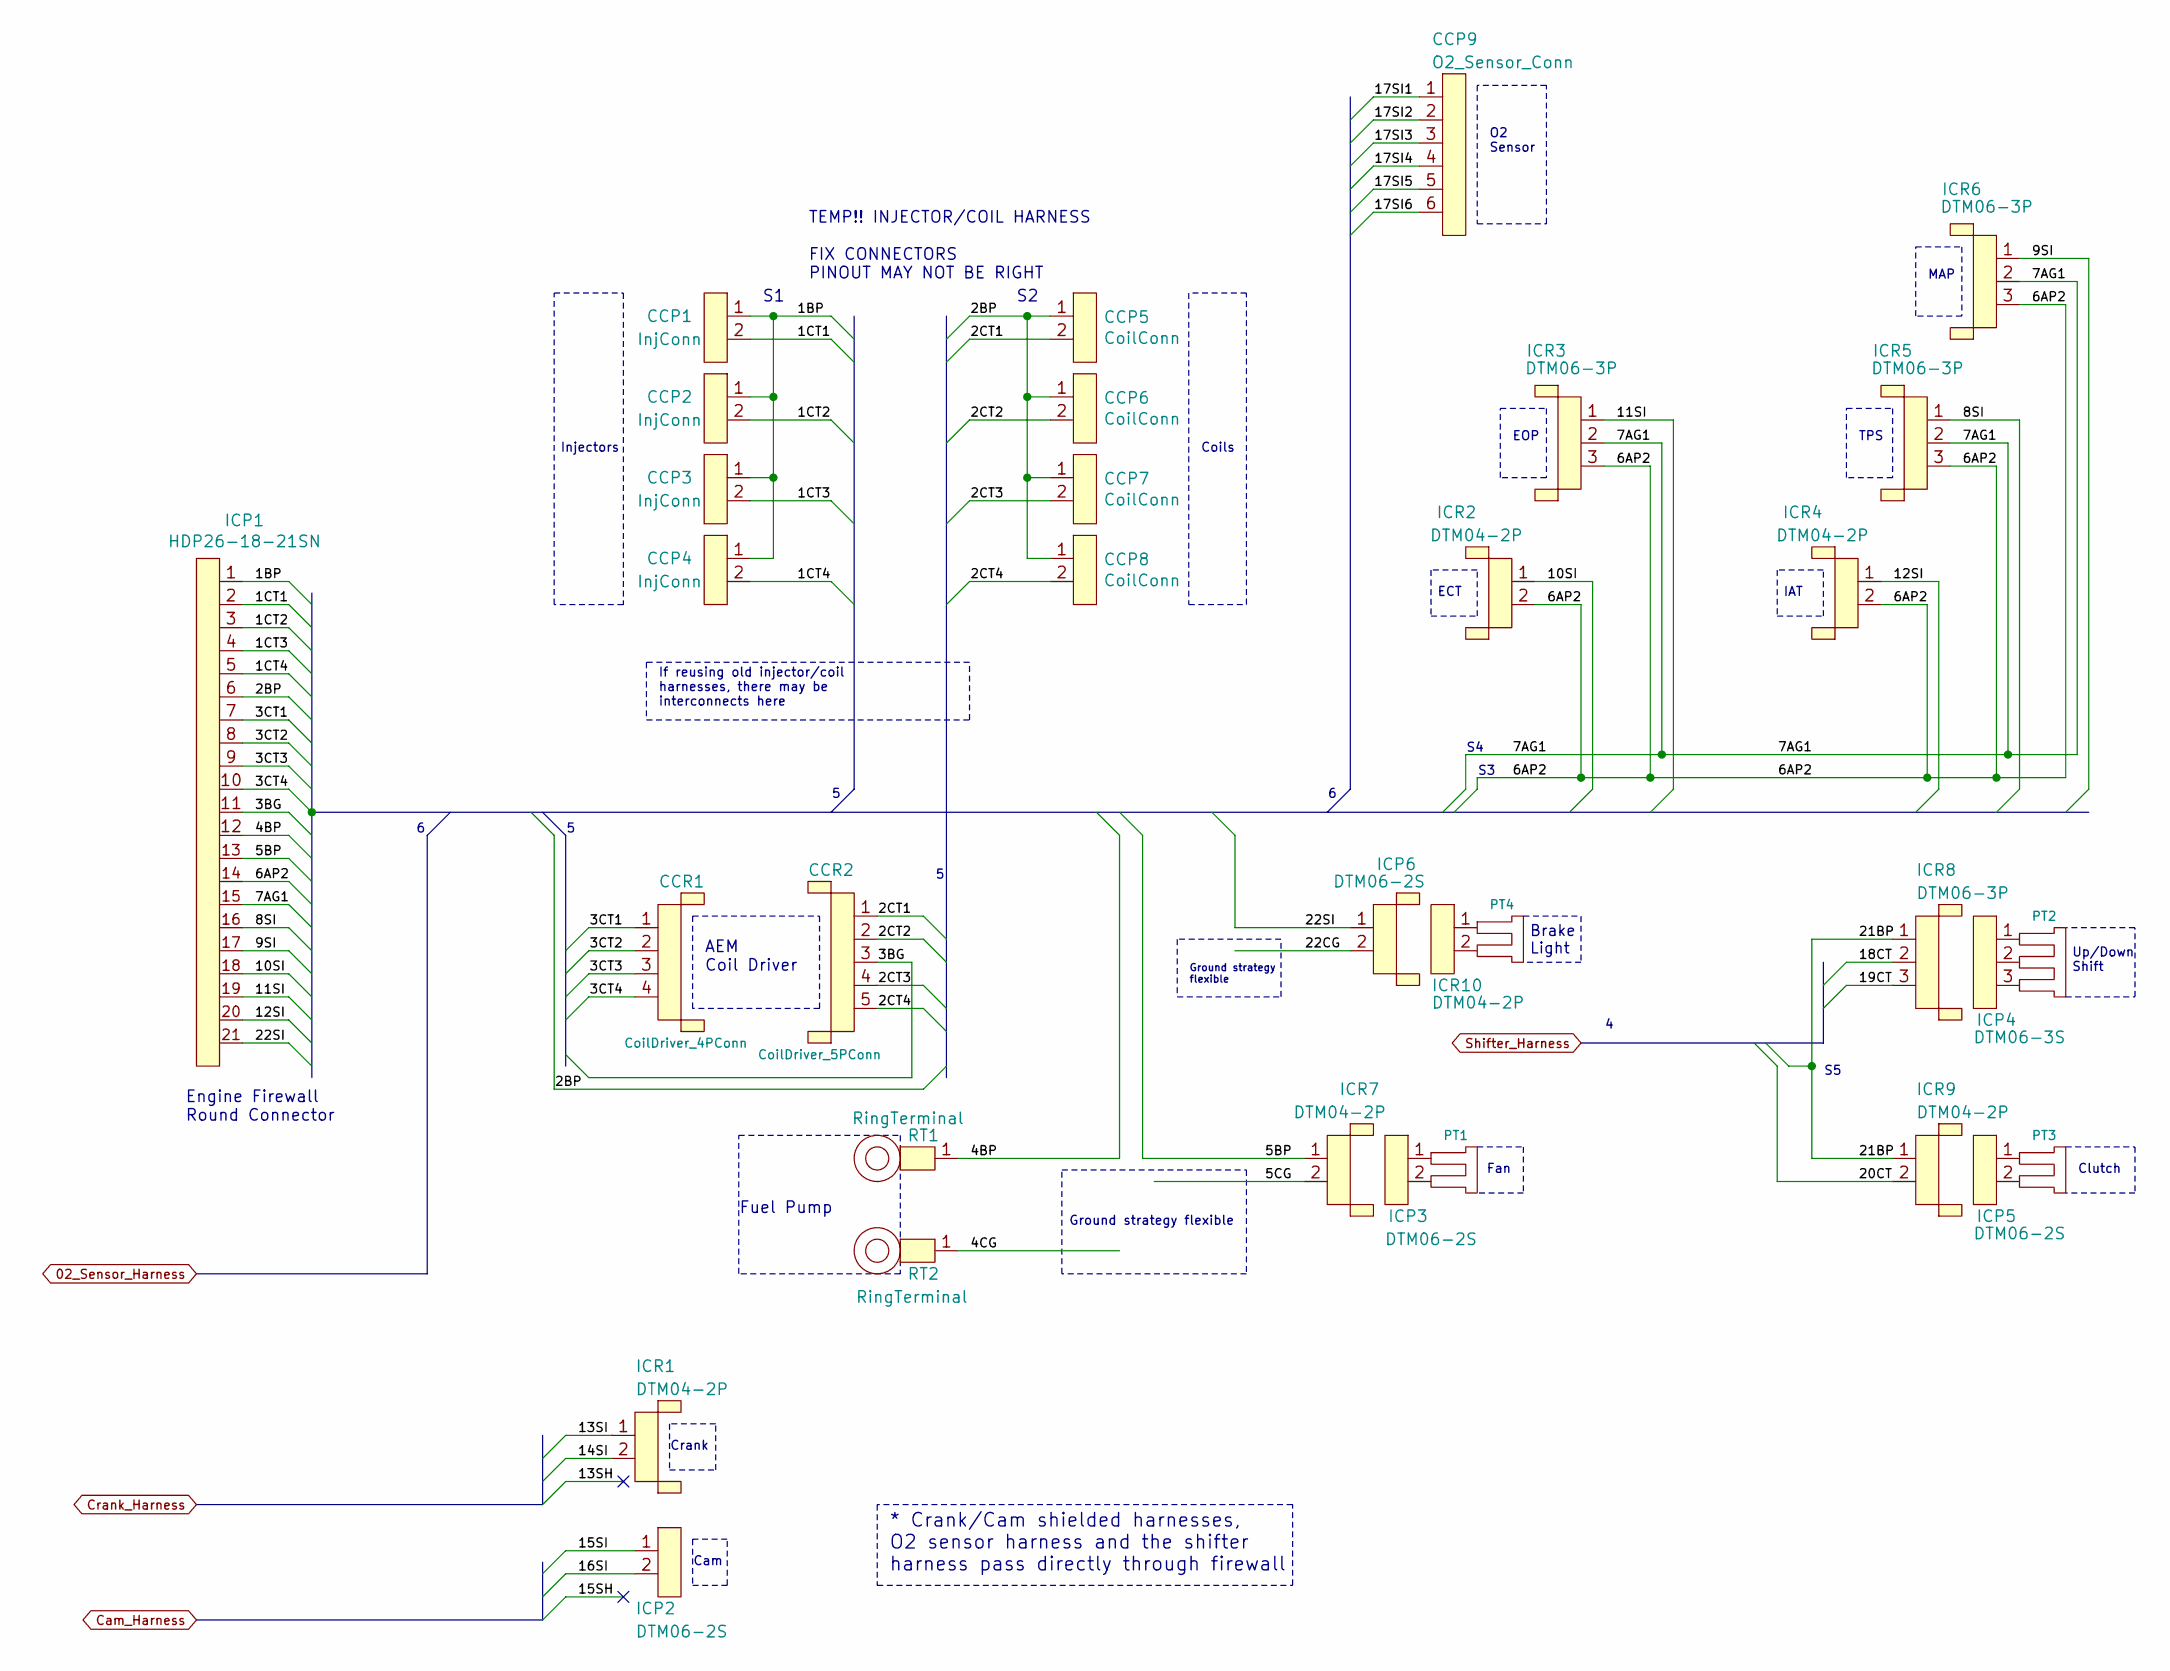
[picture p36: schematic F20_W_Eng_Sensors.sch]

Parts:
CCP1, CCP2, CCP3, CCP4: InjConn
CCP5, CCP6, CCP7, CCP8: CoilConn
CCP9: O2_Sensor_Conn
CCR1: CoilDriver_4PConn
CCR2: CoilDriver_5PConn
ICP1: HDP26-18-21SN
ICP2, ICP3, ICP5, ICP6: DTM06-2S
ICP4: DTM06-3S
ICR1, ICR2, ICR4, ICR7, ICR9, ICR10: DTM04-2P
ICR3, ICR5, ICR6, ICR8: DTM06-3P
PT1, PT3, PT4: CompPigTail_2
PT2: CompPigTail_3
RT1, RT2: RingTerminal

Connections:
1BP: CCP1.1, CCP2.1, CCP3.1, CCP4.1, ICP1.1
1CT1: CCP1.2, ICP1.2
1CT2: CCP2.2, ICP1.3
1CT3: CCP3.2, ICP1.4
1CT4: CCP4.2, ICP1.5
2BP: CCP5.1, CCP6.1, CCP7.1, CCP8.1, ICP1.6
2CT1: CCP5.2, CCR2.1
2CT2: CCP6.2, CCR2.2
2CT3: CCP7.2, CCR2.4
2CT4: CCP8.2, CCR2.5
3BG: CCR2.3, ICP1.11
3CT1: CCR1.1, ICP1.7
3CT2: CCR1.2, ICP1.8
3CT3: CCR1.3, ICP1.9
3CT4: CCR1.4, ICP1.10
4BP: ICP1.12, RT1.1
4CG: RT2.1
5BP: ICP1.13, ICR7.1
5CG: ICR7.2
6AP2: ICP1.14, ICR2.2, ICR3.3, ICR4.2, ICR5.3, ICR6.3
7AG1: ICP1.15, ICR3.2, ICR5.2, ICR6.2
8SI: ICP1.16, ICR5.1
9SI: ICP1.17, ICR6.1
10SI: ICP1.18, ICR2.1
11SI: ICP1.19, ICR3.1
12SI: ICP1.20, ICR4.1
13SI: ICR1.1
14SI: ICR1.2
15SI: ICP2.1
16SI: ICP2.2
17SI1: CCP9.1
17SI2: CCP9.2
17SI3: CCP9.3
17SI4: CCP9.4
17SI5: CCP9.5
17SI6: CCP9.6
18CT: ICR8.2
19CT: ICR8.3
20CT: ICR9.2
21BP: ICR8.1, ICR9.1
22CG: ICR10.2
22SI: ICP1.21, ICR10.1
unnamed: ICP3.1, PT1.~
unnamed: ICP3.2, PT1.~
unnamed: ICP4.1, PT2.~
unnamed: ICP4.2, PT2.~
unnamed: ICP4.3, PT2.~
unnamed: ICP5.1, PT3.~
unnamed: ICP5.2, PT3.~
unnamed: ICP6.1, PT4.~
unnamed: ICP6.2, PT4.~

Notes on the sheet:
Engine Firewall Round Connector
TEMP!! INJECTOR/COIL HARNESS FIX CONNECTORS PINOUT MAY NOT BE RIGHT
AEM Coil Driver
Fuel Pump
Ground strategy flexible
Coils
ECT
Injectors
EOP
IAT
TPS
MAP
Fan
Cam
Crank
* Crank/Cam shielded harnesses, O2 sensor harness and the shifter harness pass directly through firewall
O2 Sensor
If reusing old injector/coil harnesses, there may be interconnects here
Up/Down Shift
Clutch
Brake Light
Ground strategy flexible
