CValadez94/F20_Schematics/Schematics/F20_Wiring_Diagrams/F20_ROOT_WIRING/F20_W_Engine_Sensors.sch

## KiCad design Schematics/F20_Wiring_Diagrams/F20_ROOT_WIRING/F20_W_Engine_Sensors.sch (2020-06-22)

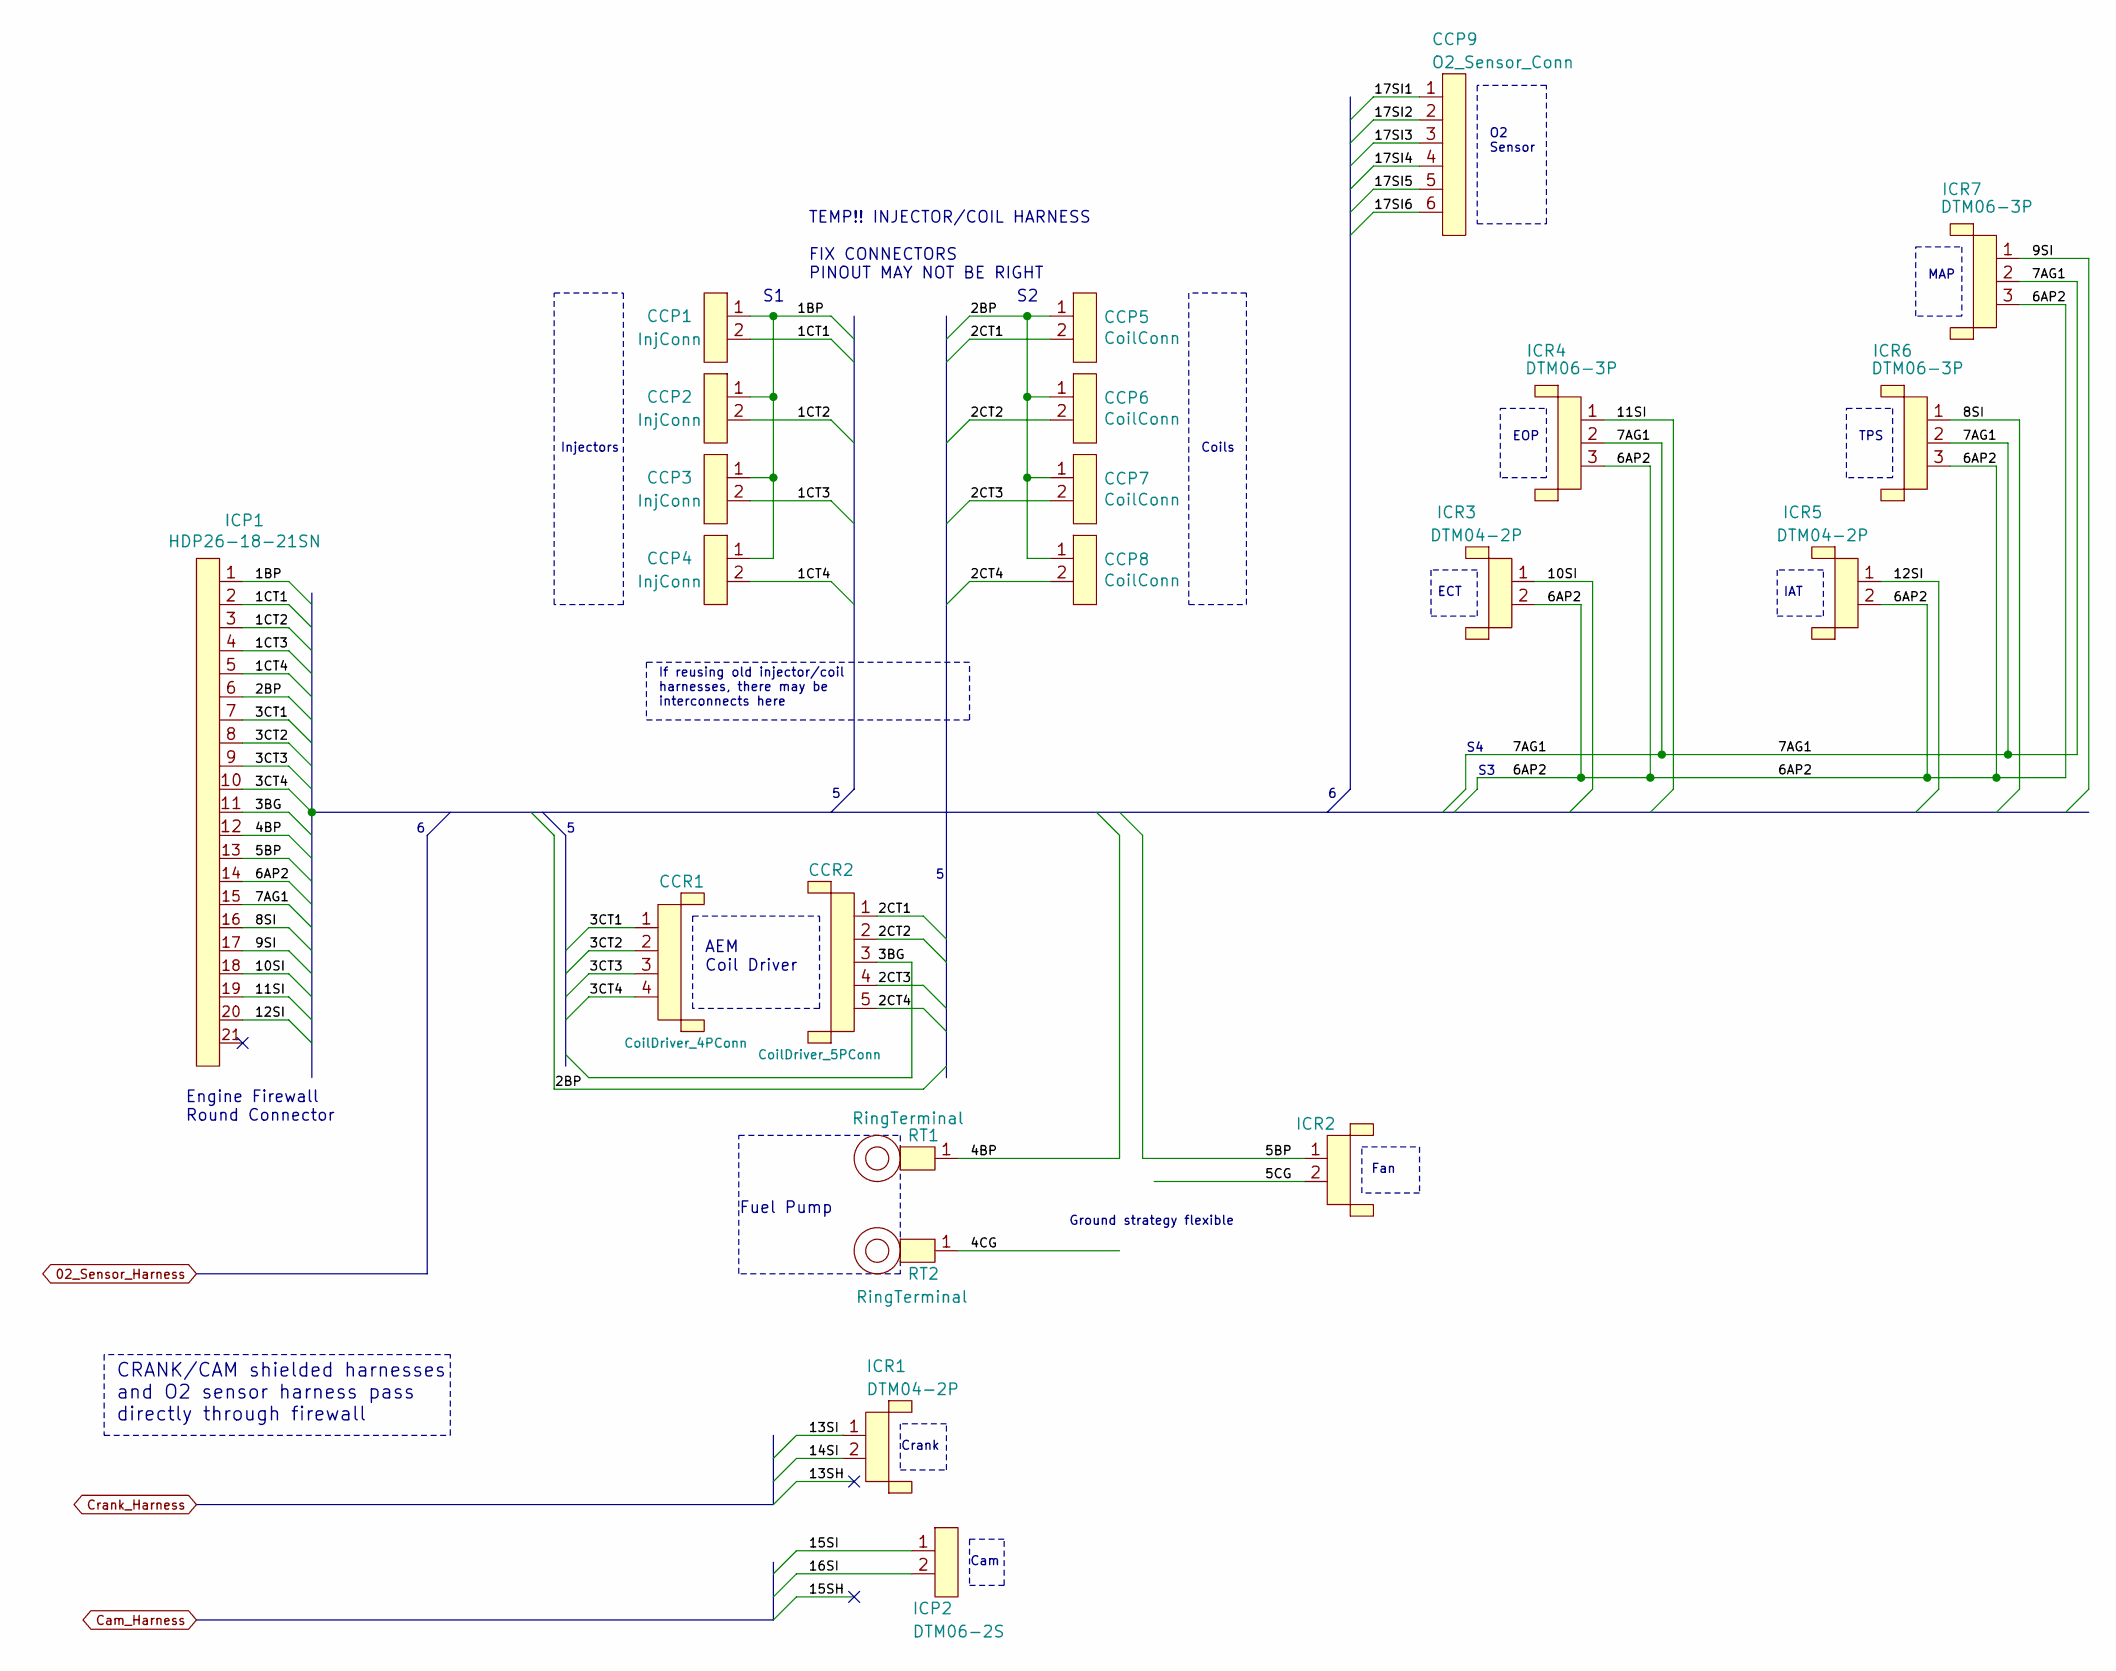
[picture p37: schematic F20_W_Engine_Sensors.sch]

Parts:
CCP1, CCP2, CCP3, CCP4: InjConn
CCP5, CCP6, CCP7, CCP8: CoilConn
CCP9: O2_Sensor_Conn
CCR1: CoilDriver_4PConn
CCR2: CoilDriver_5PConn
ICP1: HDP26-18-21SN
ICP2: DTM06-2S
ICR1, ICR2, ICR3, ICR5: DTM04-2P
ICR4, ICR6, ICR7: DTM06-3P
RT1, RT2: RingTerminal

Connections:
1BP: CCP1.1, CCP2.1, CCP3.1, CCP4.1, ICP1.1
1CT1: CCP1.2, ICP1.2
1CT2: CCP2.2, ICP1.3
1CT3: CCP3.2, ICP1.4
1CT4: CCP4.2, ICP1.5
2BP: CCP5.1, CCP6.1, CCP7.1, CCP8.1, ICP1.6
2CT1: CCP5.2, CCR2.1
2CT2: CCP6.2, CCR2.2
2CT3: CCP7.2, CCR2.4
2CT4: CCP8.2, CCR2.5
3BG: CCR2.3, ICP1.11
3CT1: CCR1.1, ICP1.7
3CT2: CCR1.2, ICP1.8
3CT3: CCR1.3, ICP1.9
3CT4: CCR1.4, ICP1.10
4BP: ICP1.12, RT1.1
4CG: RT2.1
5BP: ICP1.13, ICR2.1
5CG: ICR2.2
6AP2: ICP1.14, ICR3.2, ICR4.3, ICR5.2, ICR6.3, ICR7.3
7AG1: ICP1.15, ICR4.2, ICR6.2, ICR7.2
8SI: ICP1.16, ICR6.1
9SI: ICP1.17, ICR7.1
10SI: ICP1.18, ICR3.1
11SI: ICP1.19, ICR4.1
12SI: ICP1.20, ICR5.1
13SI: ICR1.1
14SI: ICR1.2
15SI: ICP2.1
16SI: ICP2.2
17SI1: CCP9.1
17SI2: CCP9.2
17SI3: CCP9.3
17SI4: CCP9.4
17SI5: CCP9.5
17SI6: CCP9.6

Notes on the sheet:
Engine Firewall Round Connector
TEMP!! INJECTOR/COIL HARNESS FIX CONNECTORS PINOUT MAY NOT BE RIGHT
AEM Coil Driver
Fuel Pump
Ground strategy flexible
Coils
ECT
Injectors
EOP
IAT
TPS
MAP
Fan
Cam
Crank
CRANK/CAM shielded harnesses and O2 sensor harness pass directly through firewall
O2 Sensor
If reusing old injector/coil harnesses, there may be interconnects here
