CValadez94/F20_Schematics/Schematics/F20_Wiring_Diagrams/F20_ROOT_WIRING/F20_W_Engine_Side.sch

## KiCad design Schematics/F20_Wiring_Diagrams/F20_ROOT_WIRING/F20_W_Engine_Side.sch (2020-06-18)

Schematic: F20_W_Engine_Side.sch

Parts:
CCP1, CCP2, CCP3, CCP4: InjConn
CCP5, CCP6, CCP7, CCP8: CoilConn
CCR1: CoilDriver_4PConn
CCR2: CoilDriver_5PConn
ICP1: HDP26-18-21SN
ICP2: DTM06-2S
ICR1: DTM04-2P
PT1: Fan_Pigtail
RT1, RT2: RingTerminal

Notes on the sheet:
Engine Firewall Round Connector
TEMP!! INJECTOR/COIL HARNESS FIX CONNECTORS PINOUT MAY NOT BE RIGHT
AEM Coil Driver
Fuel Pump
Ground strategy flexible
Combine grounds with fan? Ground strategy flexible
