CValadez94/F20_Schematics/(commit log)

2020-01-22 Initial upload
    [F20_ECU_Test1.sch, F20_Fuses_Relays.sch, F20_Injectors_Coils.sch, F20_Power.sch, F20_ROOT.sch]
2020-01-23 Added Driver Display schematic. Added relevant symbols.
    [F20_Driver_Display.sch, F20_ECU_Test1.sch, F20_Fuses_Relays.sch, F20_Injectors_Coils.sch, F20_ROOT.sch]
2020-01-23 crossed out Driver Display
2020-01-26 Added brake light component
    In the original schematic the brake line wire was routed through something labeled "DTM12", I left this out and made a direct connection to the ECU.
    [BreakLight.sch, F20_Driver_Display.sch, F20_ECU_Test1.sch, F20_Fuses_Relays.sch, F20_Injectors_Coils.sch, F20_Power.sch, F20_ROOT.sch]
2020-01-26 Revert "Ad ws"
    [BreakLight.sch, DriverDisplay.sch, F20_Driver_Display.sch, F20_ECU_Test1.sch, F20_Fuses_Relays.sch, F20_Injectors_Coils.sch, F20_Power.sch, F20_ROOT.sch]
2020-01-29 Added Brakes logic diagram draft, finished charging/starting schematic portion, added relevant library parts, updated README.
    [F20_Brakes.sch, F20_Driver_Display.sch, F20_ECU_Test1.sch, F20_Fuses_Relays.sch, F20_Injectors_Coils.sch, F20_ROOT.sch]
2020-01-30 Updated Brakes diagram. Updated power management diagram. Updated relevant library symbols. Updated README.
    [F20_Brakes.sch, F20_Driver_Display.sch, F20_ECU_Test1.sch, F20_Fuses_Relays.sch, F20_Injectors_Coils.sch, F20_Power_Management.sch, F20_ROOT.sch, F20_Relays_Fuses.sch]
2020-02-04 Added GND and GND_CHASSIS symbols, updated relevant schematics. Restructured Powertrain hierarchy. Created ECU Connector symbols.
    [F20_Brakes.sch, F20_Driver_Display.sch, F20_ECU.sch, F20_ECU_Test1.sch, F20_Injectors_Coils.sch, F20_Power_Management.sch, F20_Powertrain.sch, F20_ROOT.sch]
2020-02-04 Updated per AD commit. O2 sensor schematic, transponder schematic.
    [F20_Brakes.sch, F20_Driver_Display.sch, F20_ECU.sch, F20_O2_Sensor.sch, F20_Power_Management.sch, F20_Powertrain.sch, F20_ROOT.sch, F20_Relays_Fuses.sch]
2020-02-12 Weekly update. Added Tire temp sensors drawing.
    [F20_Brakes.sch, F20_Coils.sch, F20_Driver_Display.sch, F20_ECU.sch, F20_ECU_CONN1.sch, F20_O2_Sensor.sch, F20_Power_Management.sch, F20_Powertrain.sch]
2020-02-19 02/18/20 update
    [F20_Brakes.sch, F20_Coils.sch, F20_Driver_Display.sch, F20_ECU_CONN1.sch, F20_ECU_CONN2.sch, F20_O2_Sensor.sch, F20_Power_Management.sch, F20_Powertrain.sch]
2020-02-20 02/19/20 update
    [F20_Brakes.sch, F20_Coils.sch, F20_Driver_Display.sch, F20_ECU_CONN1.sch, F20_ECU_CONN2.sch, F20_RIM.sch, F20_Relays_Fuses.sch, F20_Tire_Temp_Sensors.sch]
2020-02-24 Added injectors drawing
    [F20_Brakes.sch, F20_Coils.sch, F20_Driver_Display.sch, F20_ECU_CONN1.sch, F20_ECU_CONN2.sch, F20_Injectors.sch, F20_O2_Sensor.sch, F20_Power_Management.sch]
2020-03-04 Major powertrain update, added shifting schematic
    [F20_Brakes.sch, F20_Coils.sch, F20_Driver_Display.sch, F20_ECU_CONN1.sch, F20_ECU_CONN2.sch, F20_Injectors.sch, F20_Power_Management.sch, F20_Powertrain.sch]
2020-03-12 Added steering wheel drawing, udpated some ECU pinout to match previous tune, added accel/XBEE drawing
    [F20_Accelerometer.sch, F20_Brakes.sch, F20_Coils.sch, F20_Driver_Display.sch, F20_ECU_CONN1.sch, F20_ECU_CONN2.sch, F20_Injectors.sch, F20_Power_Management.sch]
2020-03-13 Updated library. Created Wiring project, added working progress engine side harness
    [F20_ROOT_WIRING.sch, F20_W_Engine_Side.sch]
2020-06-08 Flush update
    [F20_ROOT_WIRING.sch, F20_W_Engine_Side.sch]
2020-06-08 Added PDFs
    [F20_Accelerometer.sch, F20_Brakes.sch, F20_Coils.sch, F20_Driver_Display.sch, F20_ECU_CONN1.sch, F20_ECU_CONN2.sch, F20_Injectors.sch, F20_O2_Sensor.sch]
2020-06-18 Added PDM Layout guide, updated Powertrain wiring, added a Master Connector Pinout guide, added TOC to LogicDiagrams pdf and rearranged them a bit.
    [ConnPinout_Master_2020_06_18.xlsx, F20_ECU_CONN1.sch, F20_Power_Management.sch, F20_Powertrain.sch, F20_ROOT.sch, PDM_Layout.xlsx]
2020-06-18 Updated README, added PDM_Layout.pdf
    [ConnPinout.xlsx]
2020-06-18 Added fan/fuel pump wiring
    [ConnPinout.xlsx, F20_W_Engine_Side.sch]
2020-06-20 Added wiring for ECT, IAT, TPS, MAP, EOP, O2 Sensor engine side, Cam/Crank engine side.
    [ConnPinout.xlsx]
2020-06-22 Added engine side shifter wiring. Started engine side power management wiring
    [ConnPinout.xlsx, F20_ROOT_WIRING.sch, F20_W_Engine_Sensors.sch, F20_W_Shifter_PowerManagement.sch]
2020-10-02 Re-annotated Logic Diagrams, pulled a BOM list based on Logic Diagrams
    [F20_Accelerometer.sch, F20_Brakes.sch, F20_Coils.sch, F20_Driver_Display.sch, F20_ECU_CONN1.sch, F20_ECU_CONN2.sch, F20_Injectors.sch, F20_O2_Sensor.sch]
2020-10-07 Added shifter, brake light wiring, organized pwr mgmt diagrams
    [BOM_LogicDiagrams.csv, ConnPinout.xlsx, F20_ROOT_WIRING.sch, F20_W_Cab_PowerManagement.sch, F20_W_Eng_PowerManagement.sch, F20_W_Eng_Sensors.sch, F20_W_Shifter_PowerManagement.sch]
